Leehyunbin0131/Oh-My-MobileRobot/docs/references.md

# 자료 출처 / Design references

[한국어](../README.md) · [English](../README.en.md)

제조사 자료·제품 도면·프로젝트 실측과 설계 기준의 출처입니다. 실제 규격은 [구매 부품 사양](components.ko.md), 체결부 치수는 [출력 부품 설계 규격](design.ko.md), 조립 모델 좌표는 [전체 모델](full-model.ko.md)에 있습니다.

This page identifies manufacturer data, product drawings, project measurements, and design references. Values are documented in [purchased component specifications](components.en.md), [printed part design specifications](design.en.md), and the [complete model layout](full-model.en.md).

| 대상 / Item | 출처 / Source | 적용 항목 / Scope |
| --- | --- | --- |
| 프레임 / Frame | 프로젝트 실측·요구사항 / Project measurements and requirements | 프레임 외곽·프로파일 구성 / Frame envelope and extrusion layout |
| RPLIDAR A2M12 | [SLAMTEC A2M12 datasheet v1.0](https://wiki.slamtec.com/download/attachments/83066883/LD310_SLAMTEC_rplidar_datasheet_A2M12_v1.0_en.pdf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) | 센서 외형·장착 패턴·나사 삽입 한도 / Sensor envelope, mounting pattern, screw insertion limit |
| RealSense D435i | [D400 datasheet, August 2025](https://www.realsenseai.com/wp-content/uploads/2025/08/Intel-RealSense-D400-Series-Datasheet-August-2025.pdf) | Figure 10-9: 후면 체결·외형 / Rear mounting and exterior envelope |
| XT60 / XT60H | [AMASS product catalog](https://www.china-amass.com/public/upload/20240723/c1ae9604bbe795ebfd366c9063019e3e.pdf) | Catalog page 13: 표준 단자 단면 / Standard connector cross sections |
| Arduino Mega 2560 | [Arduino hardware documentation](https://docs.arduino.cc/hardware/mega-2560/) | 기판 외곽·고정홀 / Board outline and mounting pattern |
| NT-S-DCDM1210 | 프로젝트에 제공된 제조사 매뉴얼 `NT-S-DCDM1210.pdf`, p.7 / Manufacturer manual supplied for the project, p.7 | 기판 외곽·고정홀, 매뉴얼 재배포 제외 / Board envelope and mounting pattern; manual not redistributed |
| SZH-EKBD-058 | [Product listing](https://www.devicemart.co.kr/goods/view?no=1342925), 실물 실측 / hardware measurements | 본체 외형·실측 홀 간격·방열판 여유 / Body envelope, measured hole pitch, heatsink clearance |
| SZH-EK334 | [Product listing](https://www.devicemart.co.kr/goods/view?no=10826138), 실물 실측 / hardware measurements | 실측 고정홀 간격 / Measured mounting-hole pitch |
| KIT0085 | [DFRobot official product](https://www.dfrobot.com/product-1203.html) | 모터·바퀴 제품 규격 / Motor and wheel specifications |
| Motor bracket | 판매처 제품 도면 / Supplier product drawing | 절곡 외형·중심 개구부·조정홀 / Formed envelope, center opening, adjustment holes |
| 3-inch casters | 판매처 제품 도면 / Supplier product drawing | 바퀴·장착판·회전축 치수 / Wheel, mounting plate, and swivel dimensions |
| Jetson Orin Nano Super / HFI-A9 | 시스템 구성 사양 / System hardware specification | 메인 PC·IMU 모델 / Main computer and IMU models |
| 해머형 T너트 / Hammer T-nut | 프로젝트 설계 참고 외형 / Project design reference envelope | 측면 판 키홀의 기준 외형 / Reference envelope for side-panel keyholes |

출력 부품의 치수에는 제품 규격, 실물 실측값, 설계 여유가 구분되어 있습니다. / Printed part dimensions distinguish product specifications, hardware measurements, and design clearances.

## ROS 모델 자료 / ROS model references

ROS 모델의 사용법과 프로젝트 좌표 변환은 [한국어](ros.ko.md) / [English](ros.en.md)에 있습니다. / Usage and project coordinate conversion are documented in the linked ROS pages.

| 대상 / Item | 출처 / Source | 적용 항목 / Scope |
| --- | --- | --- |
| 단위·좌표축 / Units and axes | [REP-103](https://github.com/ros-infrastructure/rep/blob/master/rep-0103.rst) | SI 단위·로봇 축·광학 프레임 / SI units, robot axes, optical frames |
| 패키지 형식 / Package format | [REP-149](https://github.com/ros-infrastructure/rep/blob/master/rep-0149.rst) | format 3, ROS_VERSION 조건부 의존성과 빌드 방식 / Conditional dependencies and build types |
| TF 발행 / TF publication | [robot_state_publisher](https://github.com/ros/robot_state_publisher) | URDF·관절 상태와 링크 변환 / URDF, joint states, and link transforms |
| 표시용 관절 상태 / Display joint states | [joint_state_publisher](https://github.com/ros/joint_state_publisher) | GUI·기본 관절 상태 / GUI and default joint states |
| URDF 매개변수화 / URDF parameters | [xacro](https://github.com/ros/xacro) | 공통 모델·모델 선택·이름 접두사 / Common description, variants, and name prefix |
| 형상 출처 / Geometry sources | [CAD 매핑 / CAD mapping](../ros/oh_my_mobilerobot_description/config/cad_mapping.json) · [메시 명세 / Mesh manifest](../ros/oh_my_mobilerobot_description/config/mesh_manifest.json) | 저장소 CAD에서 추출한 바디·원본 SHA-256 / Bodies derived from repository CAD and source SHA-256 |
