Leehyunbin0131/Oh-My-MobileRobot/hardware/camera-mount/drawings/d435i-bracket-v2-1to1.pdf

# 브라켓 1:1 제작 도면

D435i / 2020 프로파일 / V2 / 단위 mm / 모든 형상 도면 축척 1:1

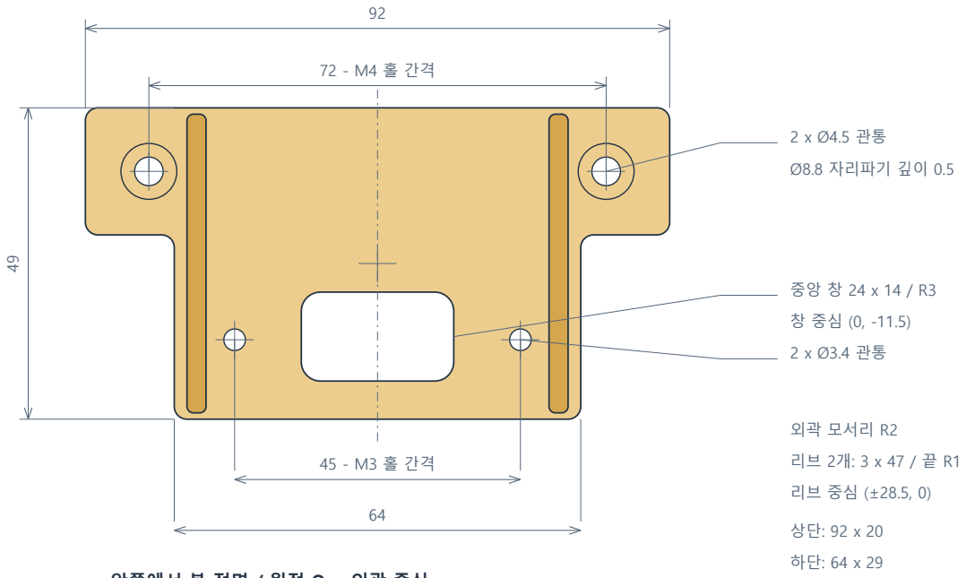
[picture p28: figure]
Ø8.8 자리파기 깊이 0.5; 외곽 모서리 R2

인쇄: 실제 크기 100% · 페이지 맞춤 해제 · 아래 50 mm 기준선으로 확인 | 1 / 2

50 mm

### 안쪽에서 본 정면 / 원점 O = 외곽 중심

64

6.5

본체 3.5

### 가로 단면 / 보강대 포함

M3 x 6 → 삽입 2.5

M4 x 8 → 홈 쪽 돌출 5

M4 받침 두께 3.0

## 홀 중심 좌표 (원점 O 기준)

용도 | X | Y | 구멍
카메라 좌 / 우 | -22.5 / +22.5 | -12.0 | Ø3.4
프로파일 좌 / 우 | -36.0 / +36.0 | +14.5 | Ø4.5 + Ø8.8 x 0.5

### 제작 순서: 외곽·구멍 스케치 → 한 바디 6.5 돌출 → 뒷면 절삭 → M4 자리파기

최종 형상: 한 개의 닫힌 솔리드. 위·아래 본체는 동일한 3.5 두께이며 가로 단차가 없음.

# 장착 위치 및 일자형 USB-C 여유 공간

D435i / 2020 프로파일 / V2 / 단위 mm / 모든 형상 도면 축척 1:1

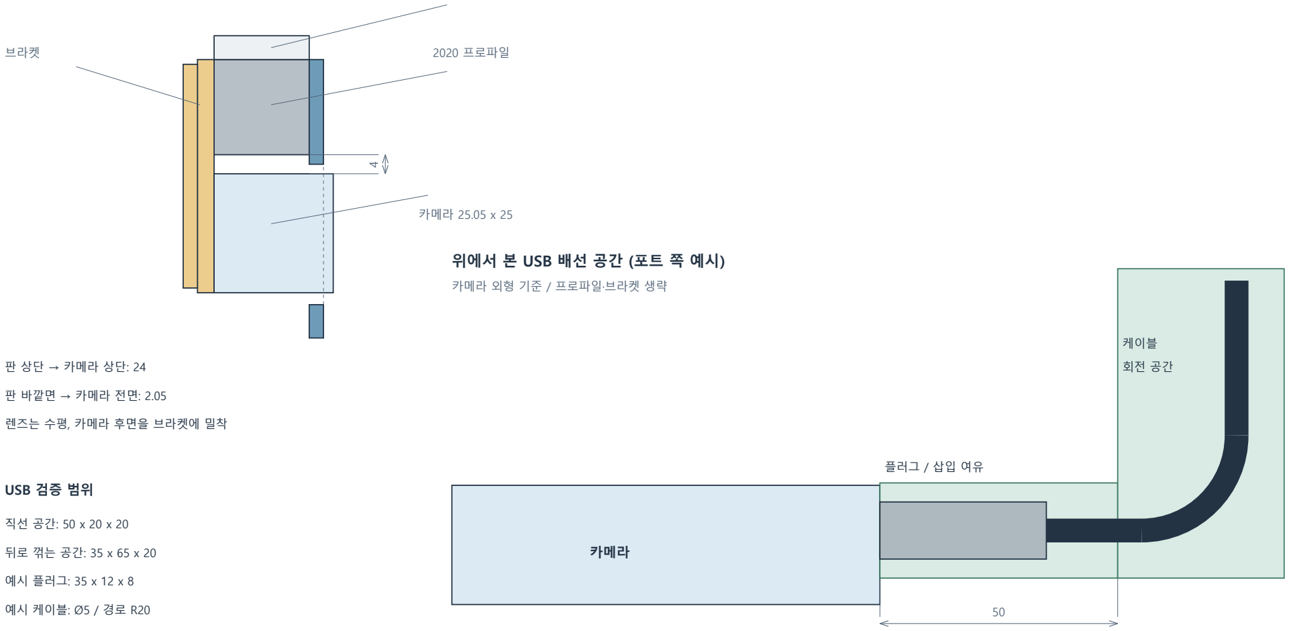
[picture p29: figure]
카메라 25.05 x 25; 2020 프로파일; 판 바깥면 → 카메라 전면: 2.05; 렌즈는 수평, 카메라 후면을 브라켓에 밀착; 위에서 본 USB 배선 공간 (포트 쪽 예시); 카메라 외형 기준 / 프로파일·브라켓 생략; 카메라; 플러그 / 삽입 여유; 케이블; USB 검증 범위; 예시 플러그: 35 x 12 x 8; 예시 케이블: Ø5 / 경로 R20

인쇄: 실제 크기 100% · 페이지 맞춤 해제 · 아래 50 mm 기준선으로 확인 | 2 / 2

50 mm

## 측면 배치 (로봇 안쪽 ← / → 바깥)

브라켓

기존 상판 5T

판 상단 → 카메라 상단: 24

실제 케이블 몸통 치수·최소 굽힘 반경은 미확인.

녹색은 물체가 없는 공간. 예시 플러그와 경로는 실측 제품 형상이 아님.
