Leehyunbin0131/Oh-My-MobileRobot/hardware/side-panels/drawings/side-panel-180-1to1.pdf

# 180 mm 추가 측면 판

### 폭 180 × 높이 140 / 표면 1 + 안쪽 리브 2 = 최대 3 mm / 축척 1:1

출력 수량: 1개

기존 측면 판과 같은 구조

환기 구멍 없음

표면 1 / 보강 포함 최대 3

가장자리 폭 6

세로 리브 3개 / 가로 1개

리브 폭 2.4 / 포켓 R2

바깥 모서리 0.5 × 45°

M4 × 8 + T너트 4세트

고정 중심 X = 40, 145

고정 중심 Y = 10, 130

T너트 삽입구 14 × 8 R1

볼트 이동 통로 폭 4.5

판을 가로로 15 mm 이동

확대 삽입구는 고정점 오른쪽

평평한 외측면을 베드에

단위 mm / 100% 크기 인쇄

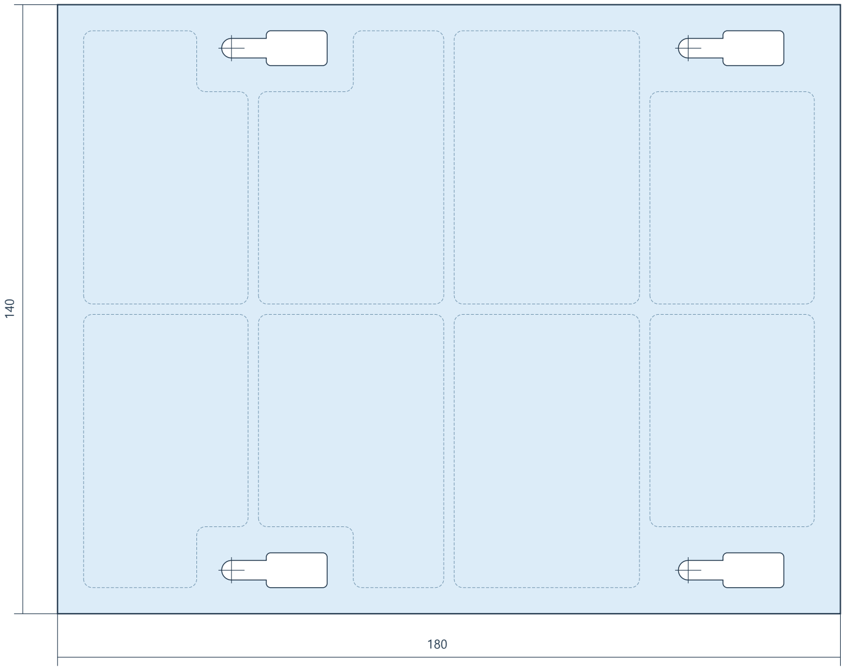
[picture p30: figure]

실선: 외곽·관통 체결구 / 점선: 안쪽 경량 포켓. 도면과 같은 치수로 SolidCraft 모델링.
