Leehyunbin0131/Oh-My-MobileRobot/docs/components.ko.md

# 구매 부품 사양

[한국어 README](../README.md) · [English](components.en.md) · [자료 출처](references.md) · [ROS 모델](ros.ko.md)

구매 부품의 모델·수량·제품 규격을 설명합니다. 치수는 mm입니다. 프레임 내 장착 위치는 [전체 모델 배치](full-model.ko.md#layout), 기판 고정홀과 전장판 배치는 [출력 부품 설계 규격](design.ko.md#electronics-trays)에 있습니다.

## 구동부 — DFRobot KIT0085

DFRobot Rubber Wheel & Motor Kit의 모터와 바퀴를 각각 2개 사용합니다.

| 항목 | 제품 규격 |
| --- | --- |
| 모터 | 28PA51G, 12 V |
| 모터 외형 | 123 × 36 × 36 |
| 바퀴 | Ø136 × 폭 24 |

## 모터 브라켓 — 범용 금속 브라켓 2개

750/755/775/795/895 DC 모터와 28/35/42 스테퍼 모터용으로 판매되는 범용 브라켓입니다.

| 항목 | 제공된 제품 도면 기준 |
| --- | --- |
| 폭 | 50 ±0.1 |
| 절곡 후 세로 다리 | 51~51.5 |
| 절곡 후 바닥 다리 | 53~53.5 |
| 전개 길이 | 100 ±0.1 |
| 모터 중심 개구부 | Ø22.1 |
| 모터 측 조정홀 | 도면 표기 4×Ø3.5, 조정 범위 20~31 |
| 바닥 슬롯 | 폭 4.2, 끝단 R2.1, 도면상 길이 치수 30 |
| 바닥 슬롯 열 간격 | 30 ±0.1 |

## 캐스터 — 3인치, 2개

| 항목 | 제공된 제품 도면 기준 |
| --- | --- |
| 바퀴 지름 | Ø76 |
| 전체 설치 높이 | 101 |
| 폭 표시값 | 33 |
| 장착판 외곽 | 95 × 64 |
| 장착 슬롯 열 간 세로 피치 | 44.5 |
| 가로 피치 표시 | 기준 72.3 / 조정 범위 68.3~76.3 |
| 슬롯 폭 | 8.5, 끝단 R4.3 표기 |
| 추가 원형 홀 | Ø9 표기 |
| 회전 중심과 바퀴 축 오프셋 | 도면 표시 34 |
| 장착판 윗면부터 바퀴 축까지 | 도면 표시 63 |

## 연산·제어·센서

| 부품 | 수량 | 역할·제품 정보 |
| --- | --- | --- |
| NVIDIA Jetson Orin Nano Super | 1 | 메인 PC |
| Arduino Mega 2560 | 1 | 마이크로컨트롤러 |
| NT-S-DCDM1210 | 1 | 모터 드라이버 |
| RPLIDAR A2M12 | 1 | 라이다, 외형 Ø76 × 높이 41 |
| RealSense D435i | 1 | 깊이 카메라 |
| HFI-A9 | 1 | IMU |

## DC-DC 컨버터

| 부품 | 수량 | 제품 정보 |
| --- | --- | --- |
| SZH-EKBD-058 | 2 | 감압 모듈, 본체 60 × 51 × 22 |
| LTC3780 SZH-EK334 | 1 | 승·감압 모듈 |

## 프레임 부재 — 2020 알루미늄 프로파일

기본 베이스(`440 × 400 × 140`)와 공통 3층 확장 플랫폼의 CAD 기준 부재 구성입니다. 배치 좌표는 [전체 모델 구성과 배치](full-model.ko.md)에 있습니다.

| 구분 | 규격 | 수량 | 배치·역할 |
| --- | --- | --- | --- |
| 기본 베이스 가로 부재 | 2020 프로파일, 길이 400 | 6 | 상·하부 전·후면 4개, 상부 중앙 라이다 고정 1개, 하부 후방 캐스터 지지 1개 |
| 기본 베이스 세로 부재 | 2020 프로파일, 길이 360 | 4 | 상·하부 좌·우 측면 4개 |
| 기본 베이스 수직 기둥 | 2020 프로파일, 길이 140 | 4 | 네 바깥 모서리 수직 연결 |
| 3층 확장 기둥 | 2020 프로파일, 길이 200 | 4 | 확장 예시 공통 모서리 기둥 (하부 L 브라켓 4개, 상부 삼각 연결판 4개 결합) |
| 3층 상부 프레임·판재 | 2020 길이 400 (3개) · 360 (2개), 440 × 400 × 3 알루미늄 판재 (1장) | 1세트 | 확장 모듈 지지 플랫폼 (로봇암형은 가로 보강 부재 2개 추가) |

## 체결 부품·서포터

출력 외장·센서 브라켓·전장판 기준 체결 부품 수량입니다. 체결부 상세 치수는 [출력 부품 설계 규격](design.ko.md)에 있습니다.

| 부품 | 규격 | 수량 | 사용 위치 |
| --- | --- | --- | --- |
| 프로파일 체결 볼트·T너트 | M4 × 8 볼트 + M4 해머형 T너트 (10 × 6 × 3.5) | 50세트 | 상판 16세트, 전면·측면·후면 분할 커버 8장 32세트(판당 4곳), D435i 브라켓 2세트 |
| 센서 고정 볼트 | M3 × 6 볼트 | 6 | RPLIDAR A2M12 고정 4개(일반 머리), RealSense D435i 고정 2개 |
| 기판용 금속 서포터 | M3 PCB 서포터, 몸통 10 (수나사 5 기준) | 26 | 전장판 아래판 14곳, 위판 12곳 파일럿 홀 체결 |
| 층간 금속 서포터 | M3 PCB 서포터, 몸통 40 | 4 | 2층 전장판 모서리 층간 연결 (150 × 150 간격) |
