Leehyunbin0131/Oh-My-MobileRobot/docs/parts.en.md

# Design file index

[English README](../README.en.md) · [한국어](parts.ko.md) · [Dimensions and fasteners](design.en.md) · [Print orientations](printing.en.md)

This index covers CAD, printing, and ROS downloads and source file contents. See [printed part design specifications](design.en.md) for dimensions and mounting interfaces, [printing instructions](printing.en.md) for output settings, and [ROS model usage](ros.en.md) for running the models.

## Printed part files

| Part | Included files | Downloads |
| --- | --- | --- |
| [Top deck](design.en.md#top-deck) | Front left/right and rear left/right panels | [STL](../hardware/top-deck/print) · [CAD](../hardware/top-deck/cad) · [1:1 drawing](../hardware/top-deck/drawings/top-deck-1to1.pdf) |
| [Side covers](design.en.md#side-panels) | 200 / 220 / 180 mm panels | [STL](../hardware/side-panels/print) · [CAD](../hardware/side-panels/cad) · [180 mm panel 1:1 drawing](../hardware/side-panels/drawings/side-panel-180-1to1.pdf) |
| [D435i mount](design.en.md#camera-mount) | Left/right front covers and V2 bracket | [STL](../hardware/camera-mount/print) · [CAD](../hardware/camera-mount/cad) · [1:1 drawing](../hardware/camera-mount/drawings/d435i-bracket-v2-1to1.pdf) |
| [Electronics trays](design.en.md#electronics-trays) | Lower and upper trays | [STL](../hardware/electronics-tray/print) · [CAD](../hardware/electronics-tray/cad) |

M3 fit coupon: [download STL](../hardware/electronics-tray/print/m3-pilot-fit-coupon.stl) · [usage](printing.en.md#fit-check)

### Camera source file contents

- [camera-panels.sc](../hardware/camera-mount/cad/camera-panels.sc): contains the left/right cover history and a hidden earlier bracket; only the two covers are displayed.
- [d435i-bracket-v2.sc](../hardware/camera-mount/cad/d435i-bracket-v2.sc): the current V2 bracket source. Its printable counterpart is [d435i-bracket-v2.stl](../hardware/camera-mount/print/d435i-bracket-v2.stl).

## Complete model and application concepts

See [complete model and application concepts](full-model.en.md) for each model's exterior and layout dimensions.

| Model | CAD source and STEP |
| --- | --- |
| Base platform | <sub>[SolidCraft](../hardware/assembly/full-robot-reference.sc) · [STEP](../hardware/assembly/full-robot-reference.step)</sub> |
| Cargo carrier concept | <sub>[SolidCraft](../hardware/application-examples/cargo-concept.sc) · [STEP](../hardware/application-examples/cargo-concept.step)</sub> |
| Six-axis robot arm concept | <sub>[SolidCraft](../hardware/application-examples/arm-concept.sc) · [STEP](../hardware/application-examples/arm-concept.step)</sub> |
| Information display concept | <sub>[SolidCraft](../hardware/application-examples/display-concept.sc) · [STEP](../hardware/application-examples/display-concept.step)</sub> |

## ROS model files

Download the complete [oh_my_mobilerobot_description package](../ros/oh_my_mobilerobot_description). Its URDFs reference meshes inside the package.

| File | Contents |
| --- | --- |
| [Base platform](../ros/oh_my_mobilerobot_description/urdf/base.urdf) | `base` URDF |
| [Cargo carrier](../ros/oh_my_mobilerobot_description/urdf/cargo.urdf) | `cargo` URDF |
| [Robot arm](../ros/oh_my_mobilerobot_description/urdf/arm.urdf) | `arm` URDF |
| [Information display](../ros/oh_my_mobilerobot_description/urdf/display.urdf) | `display` URDF |
| [Common Xacro](../ros/oh_my_mobilerobot_description/urdf/oh_my_mobilerobot.urdf.xacro) | Model selection and link/joint name prefix |
| [Visual meshes](../ros/oh_my_mobilerobot_description/meshes/visual) | Metre-scale STLs in link coordinates |
| [Launch files](../ros/oh_my_mobilerobot_description/launch) · [RViz configurations](../ros/oh_my_mobilerobot_description/rviz) | ROS 1 and ROS 2 display settings |
| [CAD mapping](../ros/oh_my_mobilerobot_description/config/cad_mapping.json) · [Mesh manifest](../ros/oh_my_mobilerobot_description/config/mesh_manifest.json) | Source mapping, coordinates, colors, SHA-256 hashes, and bounds |
| [Conversion tool](../tools/generate_ros_description.py) · [Checks](../tests/test_ros_description.py) | CAD-based regeneration and model checks |

See [ROS model usage](ros.en.md) for building, launching, frames, and customization.

## File formats and selection

| Format | Contents |
| --- | --- |
| `.sc` | Editable SolidCraft source |
| `.step` | Solid geometry for exchange between CAD programs |
| `.stl` | `hardware/**/print/`: print meshes (mm); `ros/**/meshes/visual/`: visual meshes (m) |
| `.pdf` | Part and layout drawings |
| `.urdf` | ROS link, joint, visual, and collision definitions |
| `.xacro` | Common URDF source with model selection and a name prefix |

Use the STLs in each part's `print/` folder for printing. Hidden reference boards and extrusions in CAD sources are not printable parts. Complete exterior and application models are available as SolidCraft and STEP for CAD editing and exchange and URDF and Xacro for ROS. Print units and scale are covered in [printing instructions](printing.en.md); ROS units and coordinates are in the [ROS document](ros.en.md#frames).
