Leehyunbin0131/Oh-My-MobileRobot/hardware/assembly/full-robot-reference.step

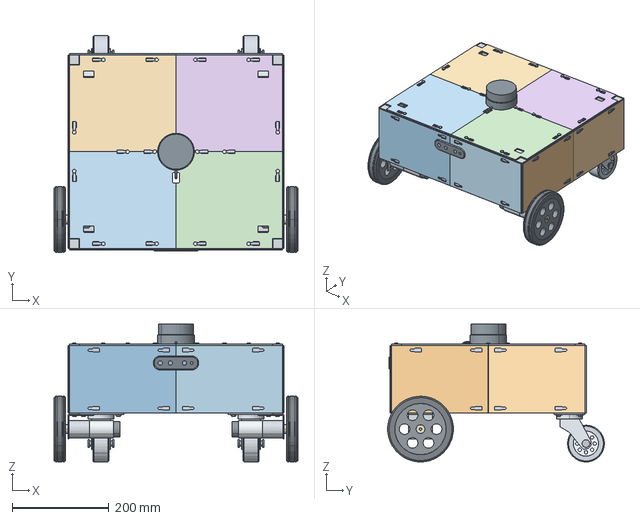
[picture p31: CAD file, 2026-11-04]
hardware/assembly/full-robot-reference.step
504.0 x 447.4 x 285.0 mm
