Leehyunbin0131/Oh-My-MobileRobot/hardware/application-examples/display-concept.step

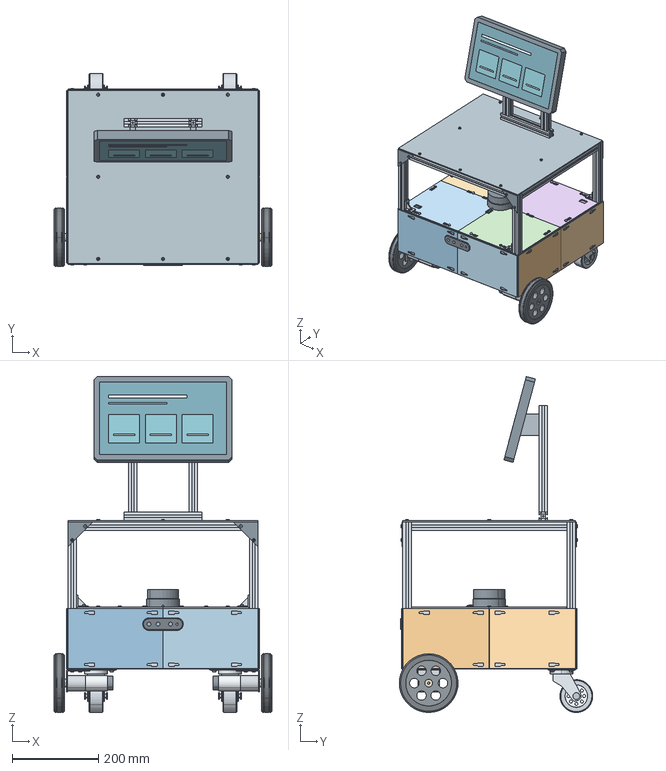
[picture p32: CAD file, 2026-11-04]
hardware/application-examples/display-concept.step
504.0 x 447.6 x 777.6 mm
