Leehyunbin0131/Oh-My-MobileRobot/hardware/camera-mount/cad/camera-panel-right.step

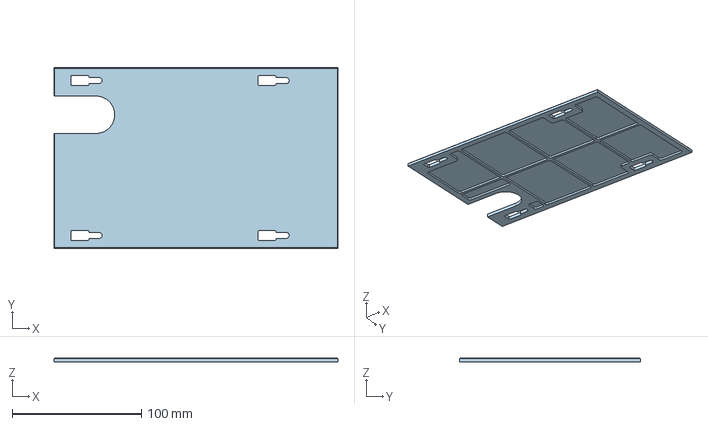
[picture p33: CAD file, 2026-11-04]
hardware/camera-mount/cad/camera-panel-right.step
220.0 x 140.0 x 3.00 mm
