Leehyunbin0131/Oh-My-MobileRobot/hardware/electronics-tray/cad/electronics-tray.step

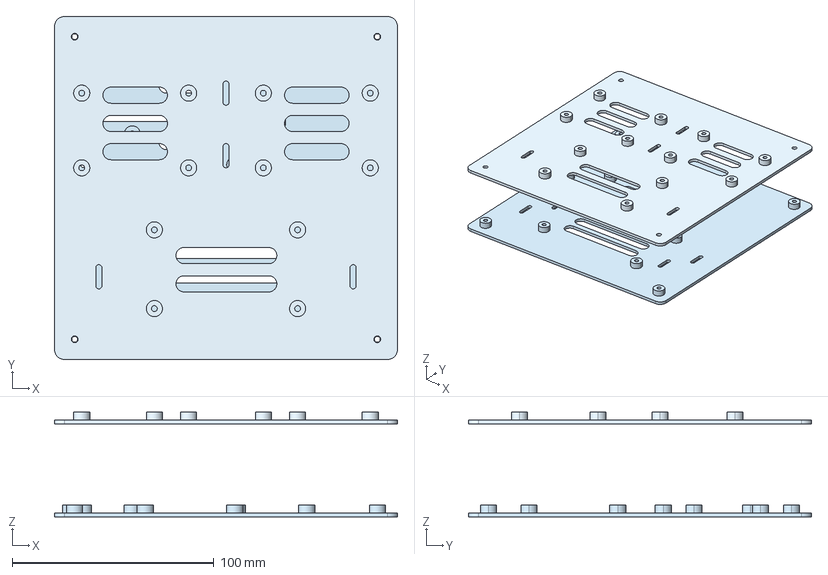
[picture p34: CAD file, 2026-11-04]
hardware/electronics-tray/cad/electronics-tray.step
170.0 x 170.0 x 52.0 mm
