Leehyunbin0131/Oh-My-MobileRobot/hardware/electronics-tray/print/lower-plate-mega180.stl

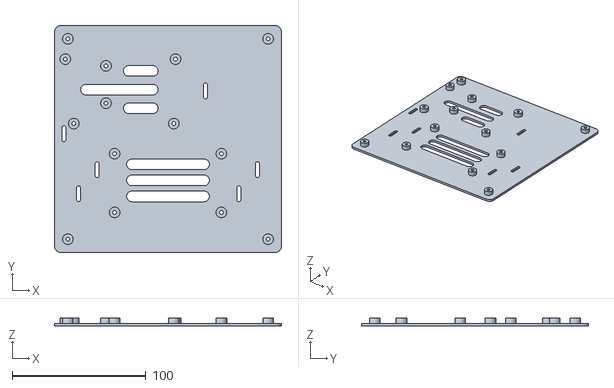
[picture p35: CAD file, 2026-11-04]
hardware/electronics-tray/print/lower-plate-mega180.stl
170.0 x 170.0 x 6.00
