Leehyunbin0131/Oh-My-MobileRobot/hardware/side-panels/cad/side-panel-180.step

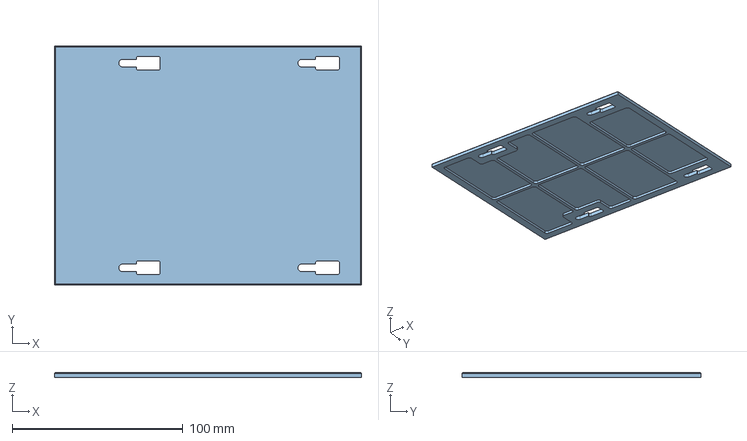
[picture p36: CAD file, 2026-11-04]
hardware/side-panels/cad/side-panel-180.step
180.0 x 140.0 x 3.00 mm
