Leehyunbin0131/Oh-My-MobileRobot/hardware/top-deck/cad/top-deck.step

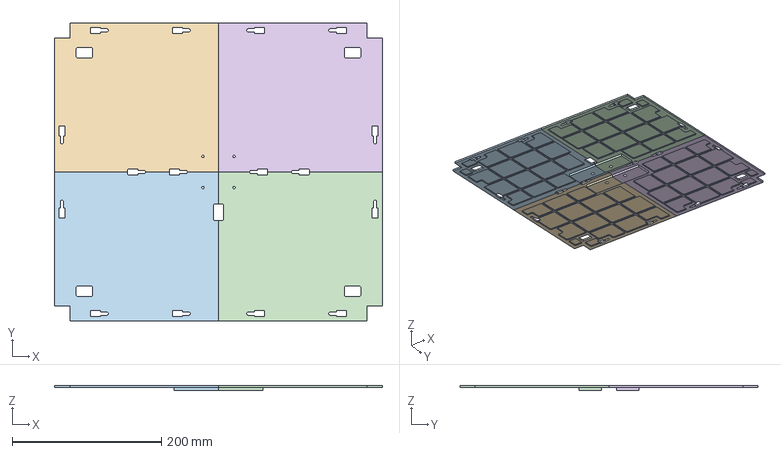
[picture p37: CAD file, 2026-11-04]
hardware/top-deck/cad/top-deck.step
440.0 x 400.0 x 7.00 mm
