Leehyunbin0131/Oh-My-MobileRobot/hardware/top-deck/print/03_Rear_Left.stl

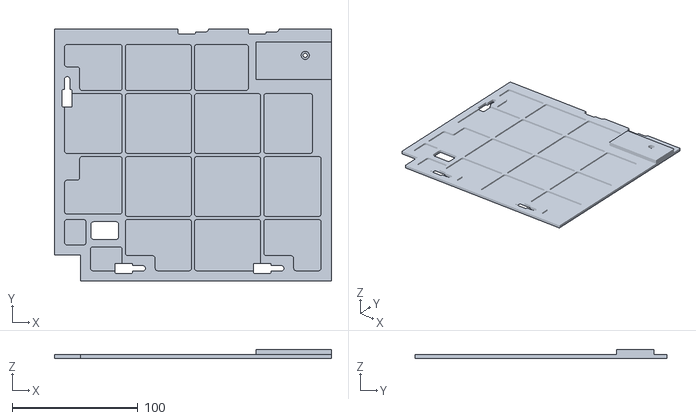
[picture p38: CAD file, 2026-11-04]
hardware/top-deck/print/03_Rear_Left.stl
220.0 x 200.0 x 7.00
