Leehyunbin0131/Oh-My-MobileRobot/ros/oh_my_mobilerobot_description/meshes/visual/arm_module/arm.stl

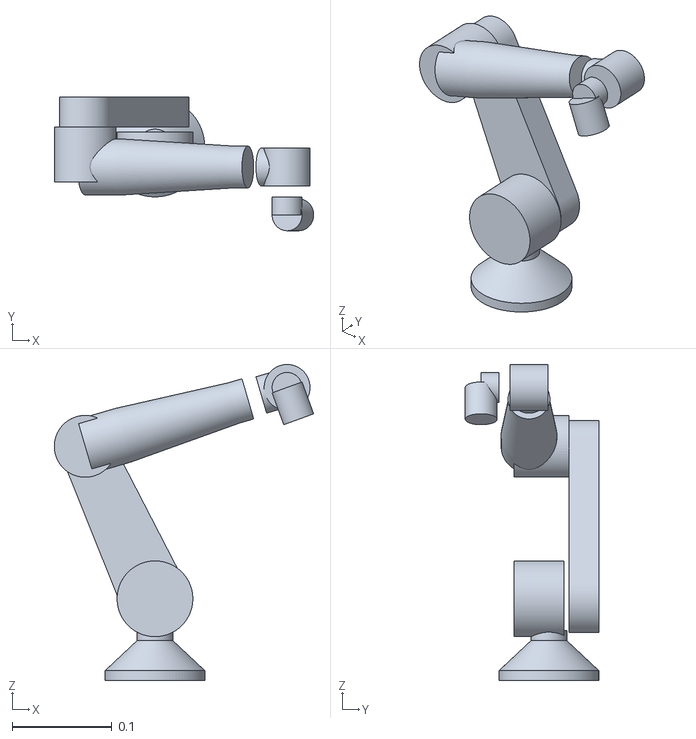
[picture p39: CAD file, 2026-11-04]
ros/oh_my_mobilerobot_description/meshes/visual/arm_module/arm.stl
0.26 x 0.134 x 0.317
