Leehyunbin0131/Oh-My-MobileRobot/ros/oh_my_mobilerobot_description/meshes/visual/base_link/deck.stl

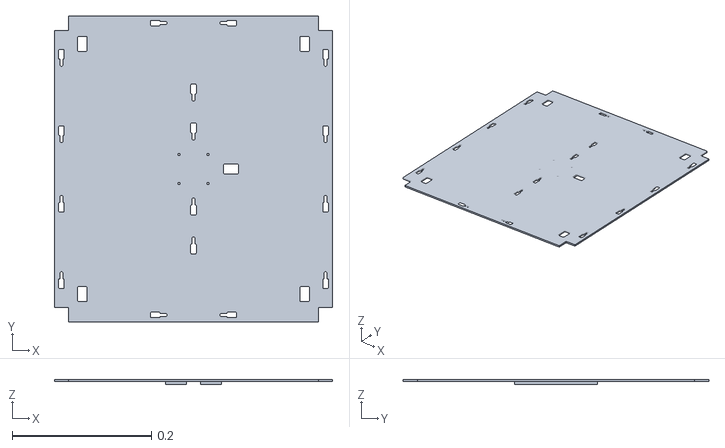
[picture p40: CAD file, 2026-11-04]
ros/oh_my_mobilerobot_description/meshes/visual/base_link/deck.stl
0.4 x 0.44 x 0.007
