Leehyunbin0131/Oh-My-MobileRobot/ros/oh_my_mobilerobot_description/meshes/visual/camera_link/sensor.stl

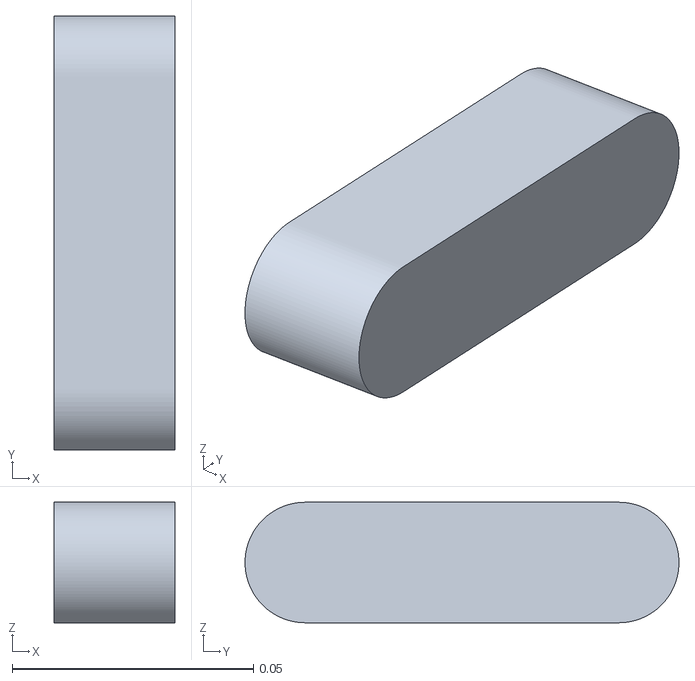
[picture p41: CAD file, 2026-11-04]
ros/oh_my_mobilerobot_description/meshes/visual/camera_link/sensor.stl
0.025 x 0.09 x 0.025
