Leehyunbin0131/Oh-My-MobileRobot/ros/oh_my_mobilerobot_description/meshes/visual/left_caster_swivel_link/metal.stl

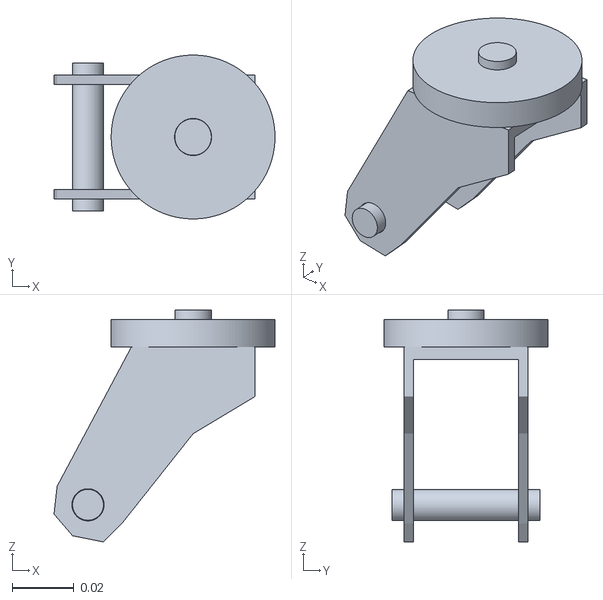
[picture p44: CAD file, 2026-11-04]
ros/oh_my_mobilerobot_description/meshes/visual/left_caster_swivel_link/metal.stl
0.0715 x 0.053 x 0.075
