Leehyunbin0131/Oh-My-MobileRobot/ros/oh_my_mobilerobot_description/meshes/visual/left_caster_wheel_link/hub.stl

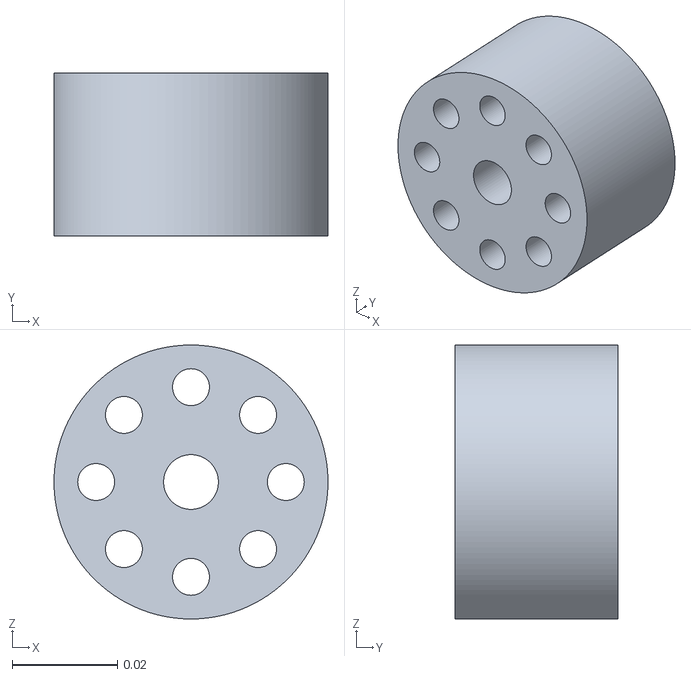
[picture p45: CAD file, 2026-11-04]
ros/oh_my_mobilerobot_description/meshes/visual/left_caster_wheel_link/hub.stl
0.052 x 0.031 x 0.052
