Leehyunbin0131/Oh-My-MobileRobot/ros/oh_my_mobilerobot_description/meshes/visual/left_wheel_link/metal.stl

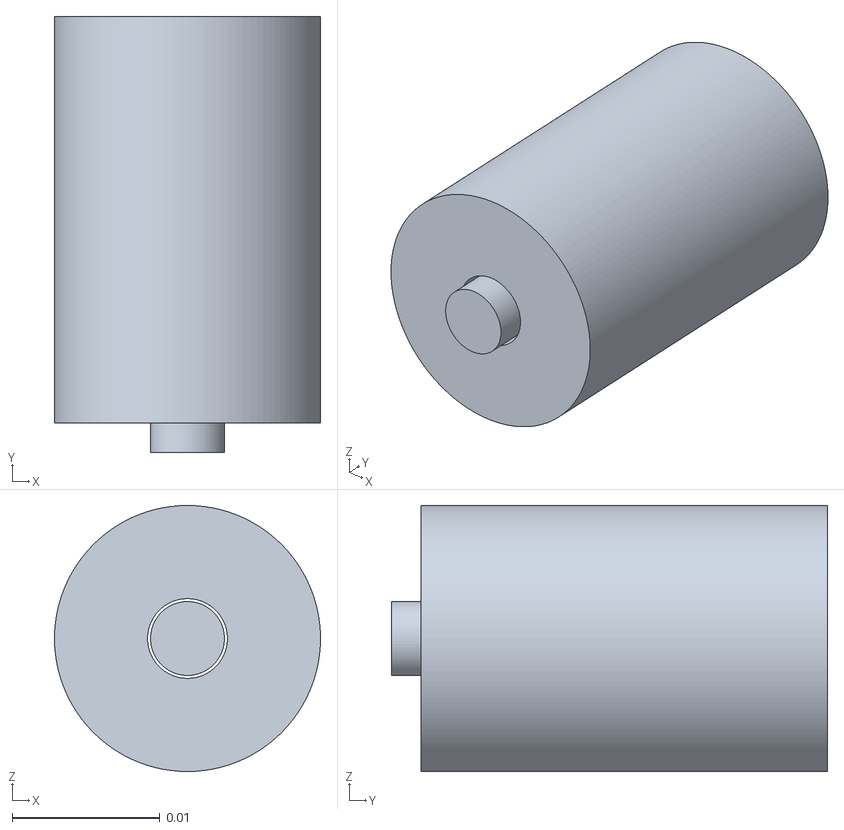
[picture p46: CAD file, 2026-11-04]
ros/oh_my_mobilerobot_description/meshes/visual/left_wheel_link/metal.stl
0.018 x 0.0295 x 0.018
