Leehyunbin0131/Oh-My-MobileRobot/ros/oh_my_mobilerobot_description/meshes/visual/lidar_link/sensor.stl

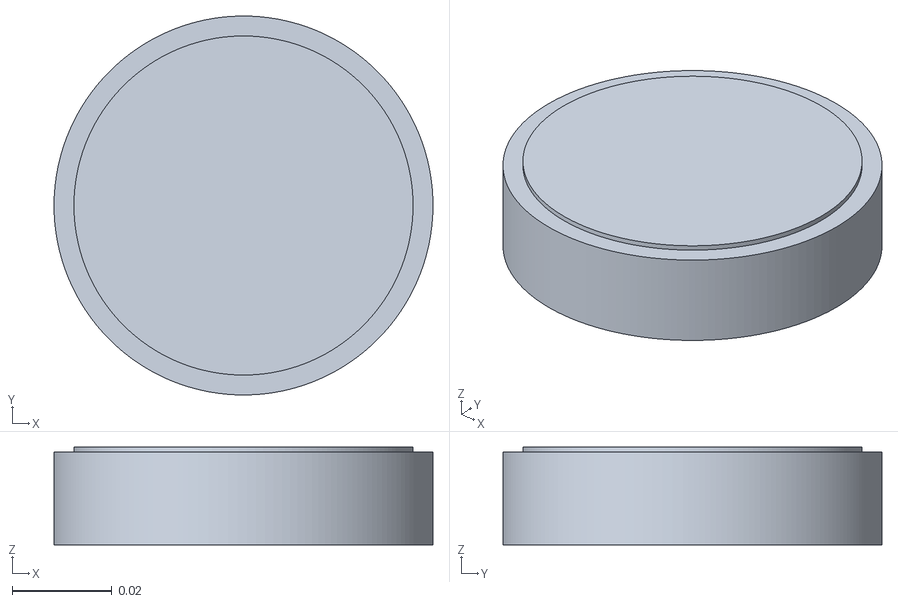
[picture p47: CAD file, 2026-11-04]
ros/oh_my_mobilerobot_description/meshes/visual/lidar_link/sensor.stl
0.076 x 0.076 x 0.0196
