Leehyunbin0131/Oh-My-MobileRobot/ros/oh_my_mobilerobot_description/meshes/visual/right_wheel_link/rubber.stl

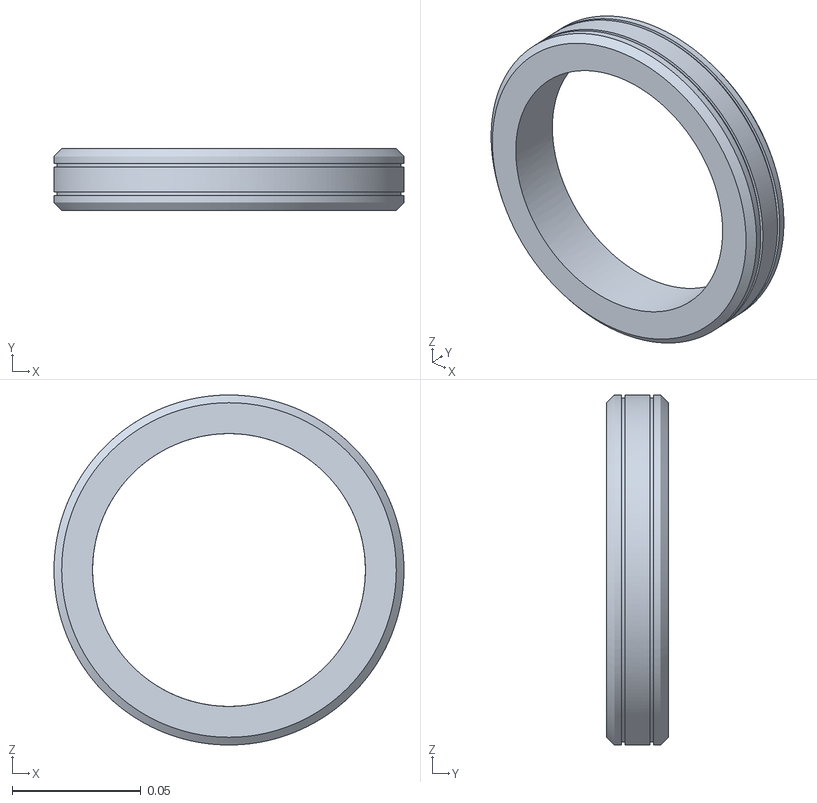
[picture p48: CAD file, 2026-11-04]
ros/oh_my_mobilerobot_description/meshes/visual/right_wheel_link/rubber.stl
0.136 x 0.024 x 0.136
