Leehyunbin0131/Oh-My-MobileRobot/hardware/application-examples/arm-concept.step

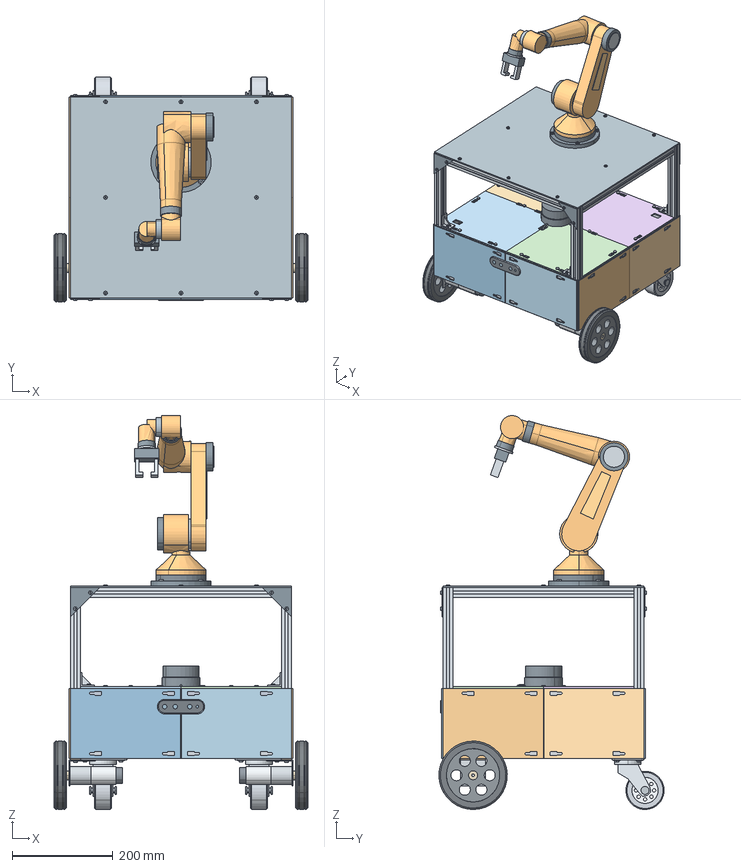
[picture p49: CAD file, 2026-11-04]
hardware/application-examples/arm-concept.step
504.0 x 447.6 x 783.1 mm
