Leehyunbin0131/Oh-My-MobileRobot/hardware/camera-mount/cad/d435i-bracket-v2.step

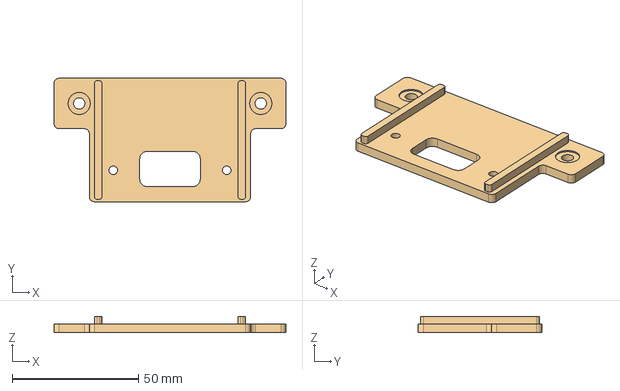
[picture p50: CAD file, 2026-11-04]
hardware/camera-mount/cad/d435i-bracket-v2.step
92.0 x 49.0 x 6.50 mm
