Leehyunbin0131/Oh-My-MobileRobot/hardware/side-panels/cad/side-panel-220.step

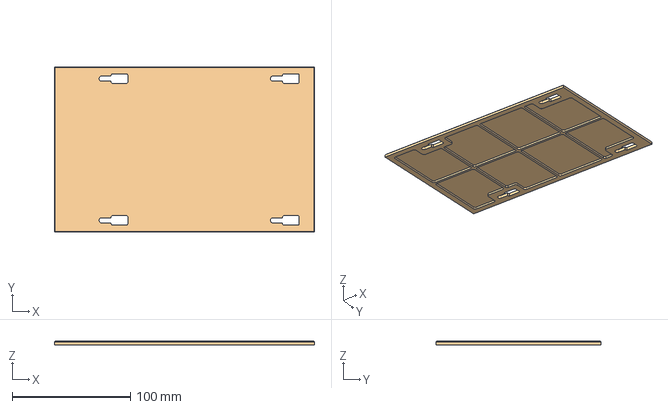
[picture p51: CAD file, 2026-11-04]
hardware/side-panels/cad/side-panel-220.step
220.0 x 140.0 x 3.00 mm
