Leehyunbin0131/Oh-My-MobileRobot/ros/oh_my_mobilerobot_description/meshes/visual/arm_module/joint.stl

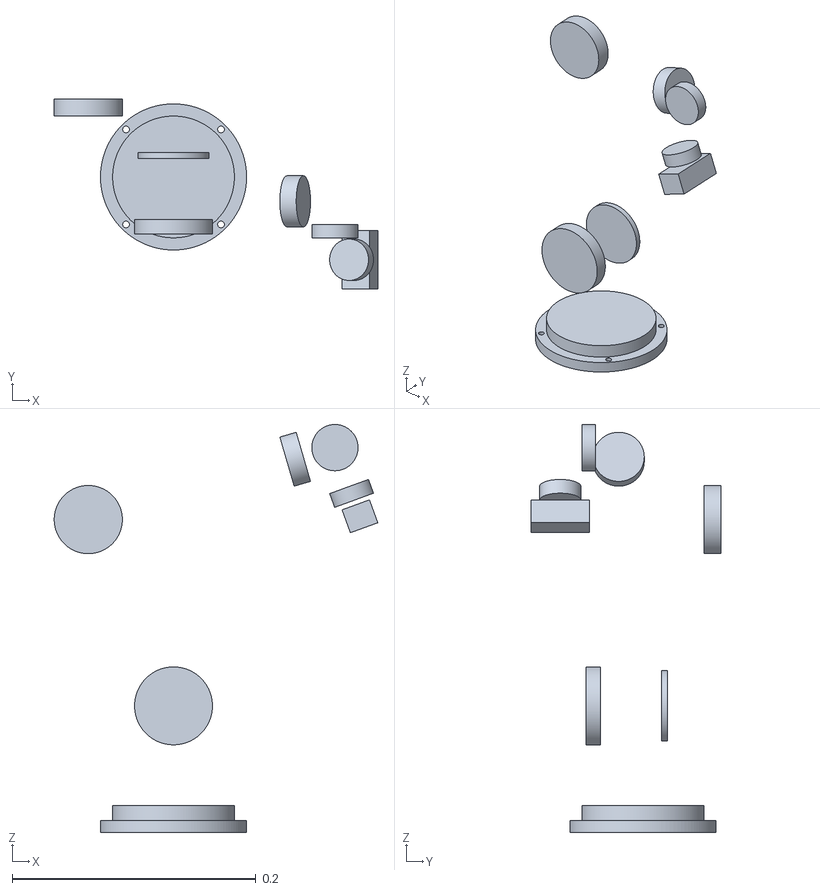
[picture p52: CAD file, 2026-11-04]
ros/oh_my_mobilerobot_description/meshes/visual/arm_module/joint.stl
0.266 x 0.156 x 0.335
