Leehyunbin0131/Oh-My-MobileRobot/ros/oh_my_mobilerobot_description/meshes/visual/base_link/joint.stl

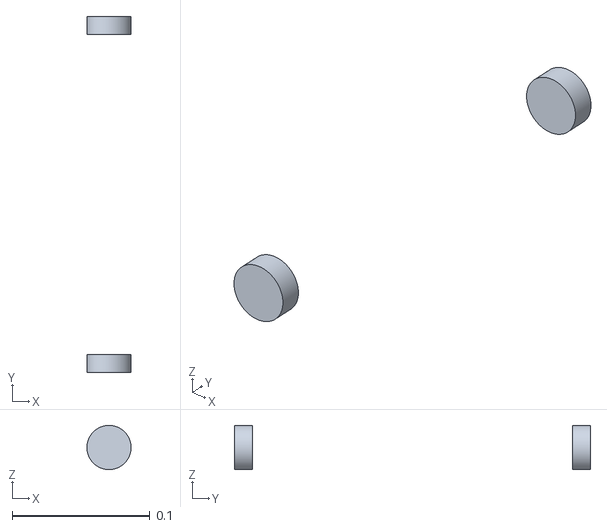
[picture p53: CAD file, 2026-11-04]
ros/oh_my_mobilerobot_description/meshes/visual/base_link/joint.stl
0.032 x 0.258 x 0.032
