Leehyunbin0131/Oh-My-MobileRobot/ros/oh_my_mobilerobot_description/meshes/visual/camera_link/rubber.stl

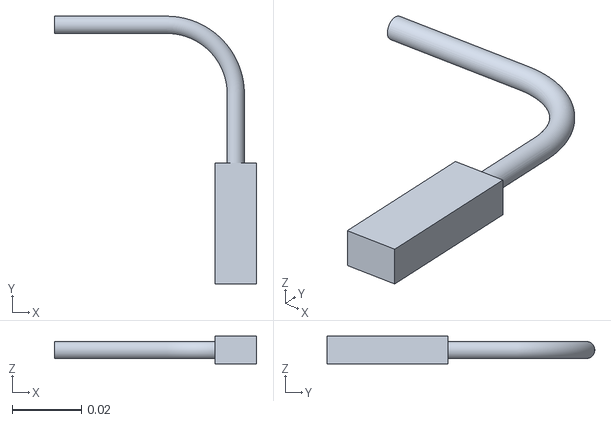
[picture p54: CAD file, 2026-11-04]
ros/oh_my_mobilerobot_description/meshes/visual/camera_link/rubber.stl
0.0585 x 0.0775 x 0.008
