Leehyunbin0131/Oh-My-MobileRobot/ros/oh_my_mobilerobot_description/meshes/visual/cargo_module/hub.stl

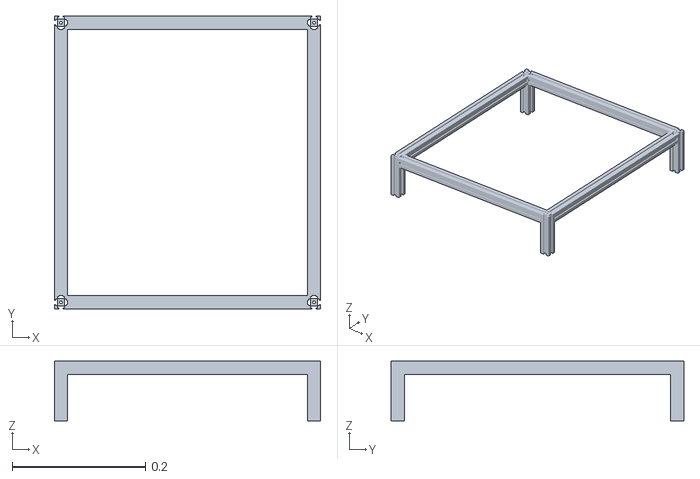
[picture p55: CAD file, 2026-11-04]
ros/oh_my_mobilerobot_description/meshes/visual/cargo_module/hub.stl
0.4 x 0.44 x 0.09
