Leehyunbin0131/Oh-My-MobileRobot/ros/oh_my_mobilerobot_description/meshes/visual/display_module/bracket.stl

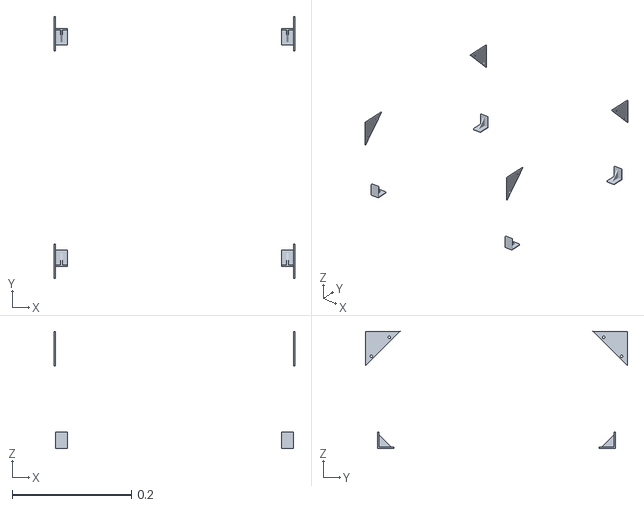
[picture p56: CAD file, 2026-11-04]
ros/oh_my_mobilerobot_description/meshes/visual/display_module/bracket.stl
0.404 x 0.44 x 0.197
