Leehyunbin0131/Oh-My-MobileRobot/ros/oh_my_mobilerobot_description/meshes/visual/left_caster_swivel_link/fastener.stl

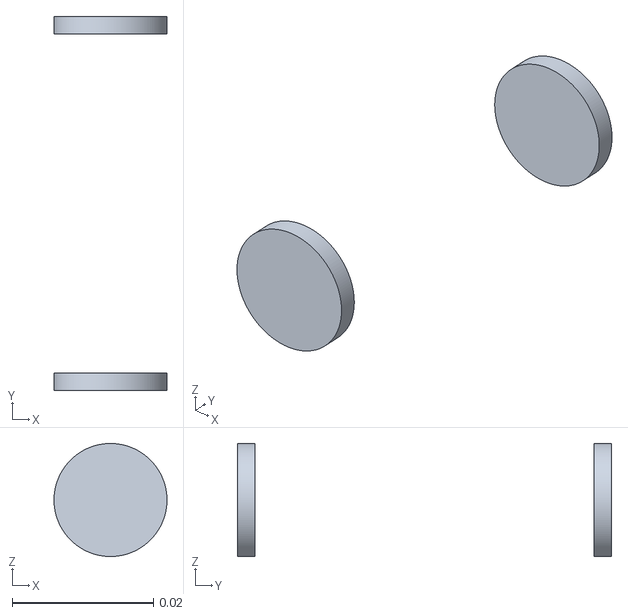
[picture p57: CAD file, 2026-11-04]
ros/oh_my_mobilerobot_description/meshes/visual/left_caster_swivel_link/fastener.stl
0.016 x 0.053 x 0.016
