Leehyunbin0131/Oh-My-MobileRobot/ros/oh_my_mobilerobot_description/meshes/visual/left_caster_wheel_link/rubber.stl

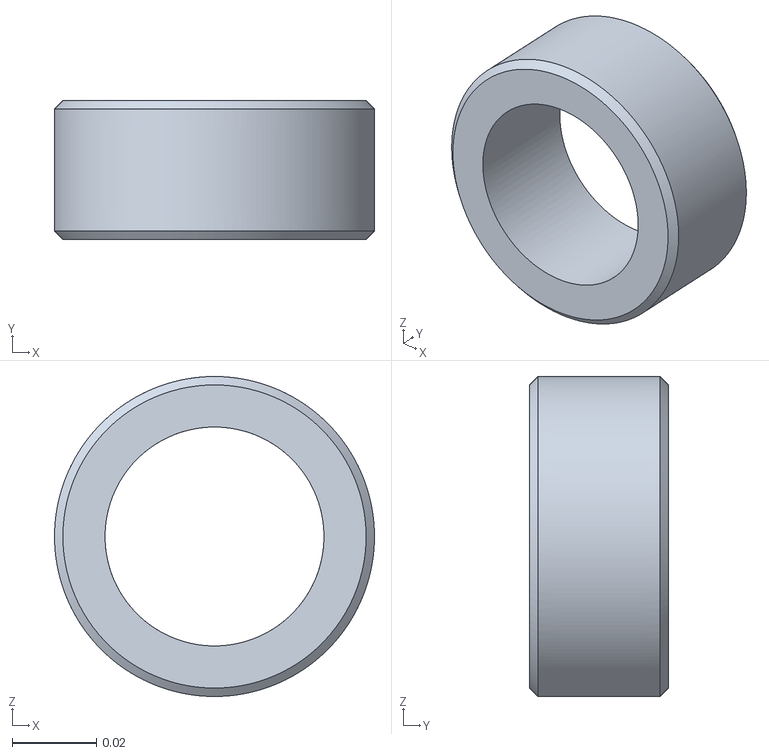
[picture p58: CAD file, 2026-11-04]
ros/oh_my_mobilerobot_description/meshes/visual/left_caster_wheel_link/rubber.stl
0.076 x 0.033 x 0.076
