Leehyunbin0131/Oh-My-MobileRobot/ros/oh_my_mobilerobot_description/meshes/visual/lidar_link/rubber.stl

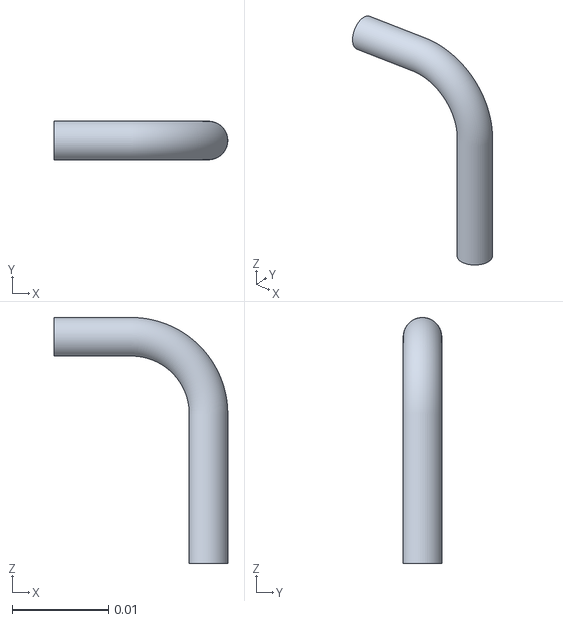
[picture p59: CAD file, 2026-11-04]
ros/oh_my_mobilerobot_description/meshes/visual/lidar_link/rubber.stl
0.018 x 0.004 x 0.0255
