Leehyunbin0131/Oh-My-MobileRobot/ros/oh_my_mobilerobot_description/meshes/visual/right_wheel_link/hub.stl

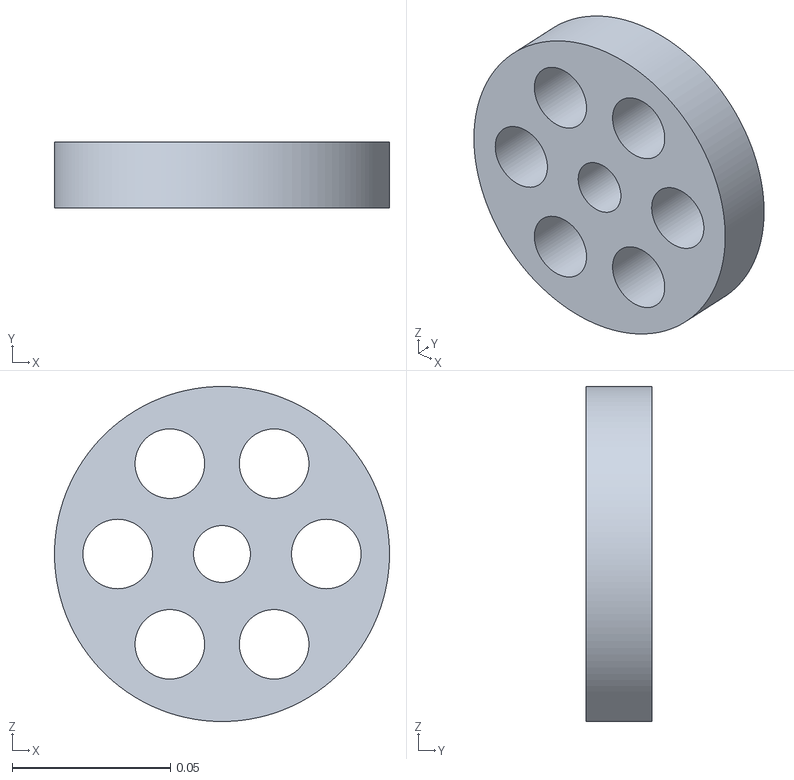
[picture p60: CAD file, 2026-11-04]
ros/oh_my_mobilerobot_description/meshes/visual/right_wheel_link/hub.stl
0.106 x 0.021 x 0.106
