Leehyunbin0131/Oh-My-MobileRobot/hardware/application-examples/cargo-concept.step

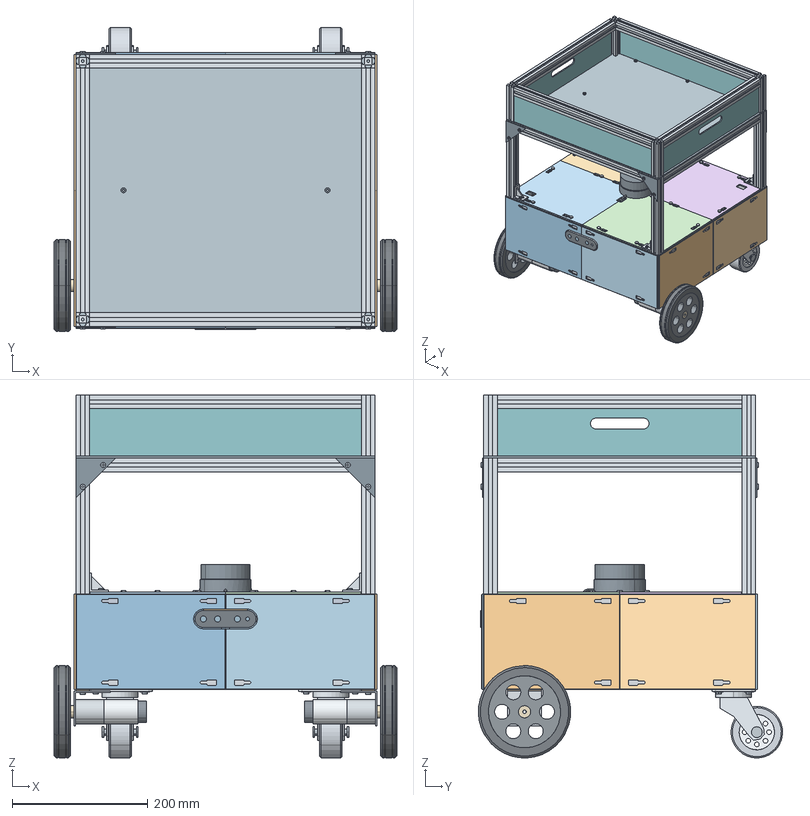
[picture p61: CAD file, 2026-11-04]
hardware/application-examples/cargo-concept.step
504.0 x 447.6 x 534.0 mm
