Leehyunbin0131/Oh-My-MobileRobot/hardware/electronics-tray/print/m3-pilot-fit-coupon.stl

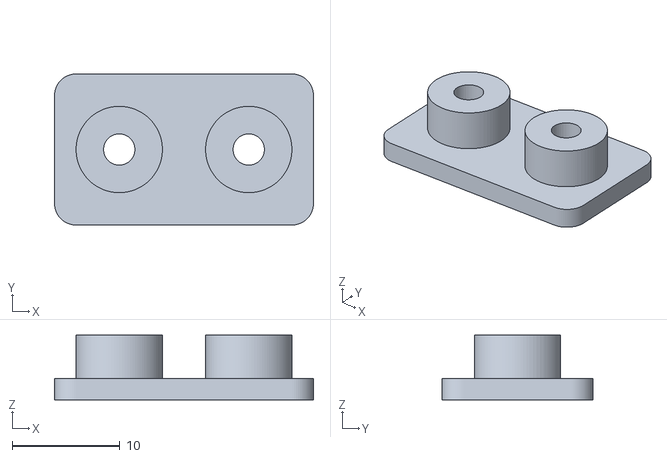
[picture p62: CAD file, 2026-11-04]
hardware/electronics-tray/print/m3-pilot-fit-coupon.stl
24.0 x 14.0 x 6.00
