Leehyunbin0131/Oh-My-MobileRobot/hardware/side-panels/cad/side-panel-200.step

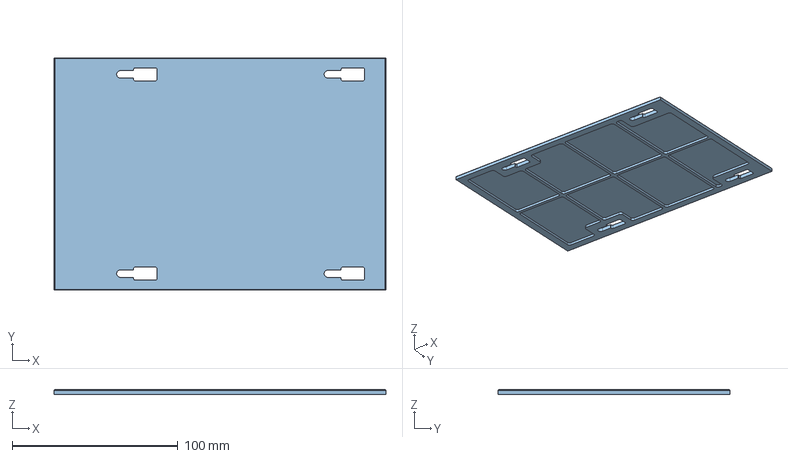
[picture p63: CAD file, 2026-11-04]
hardware/side-panels/cad/side-panel-200.step
200.0 x 140.0 x 3.00 mm
