Leehyunbin0131/Oh-My-MobileRobot/hardware/top-deck/print/01_Front_Left.stl

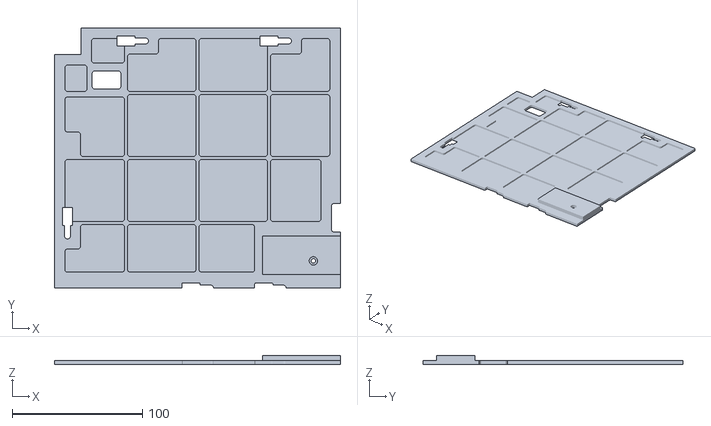
[picture p64: CAD file, 2026-11-04]
hardware/top-deck/print/01_Front_Left.stl
220.0 x 200.0 x 7.00
