Leehyunbin0131/Oh-My-MobileRobot/ros/oh_my_mobilerobot_description/meshes/visual/arm_module/fastener.stl

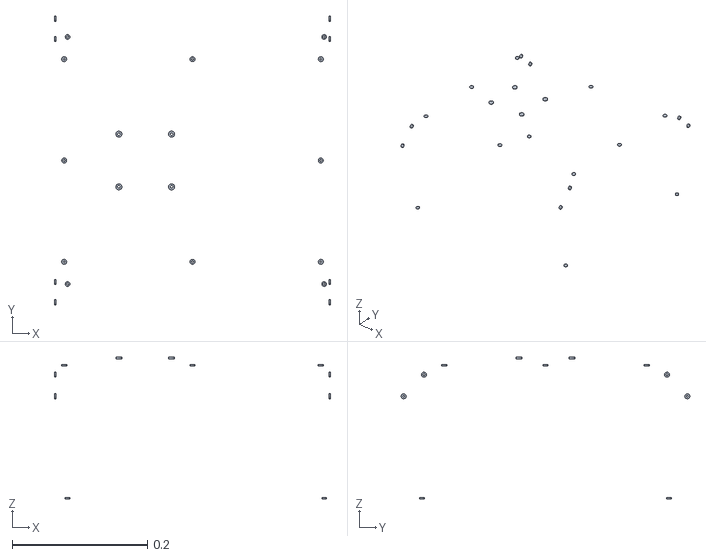
[picture p65: CAD file, 2026-11-04]
ros/oh_my_mobilerobot_description/meshes/visual/arm_module/fastener.stl
0.409 x 0.428 x 0.21
