Leehyunbin0131/Oh-My-MobileRobot/ros/oh_my_mobilerobot_description/meshes/visual/base_link/metal.stl

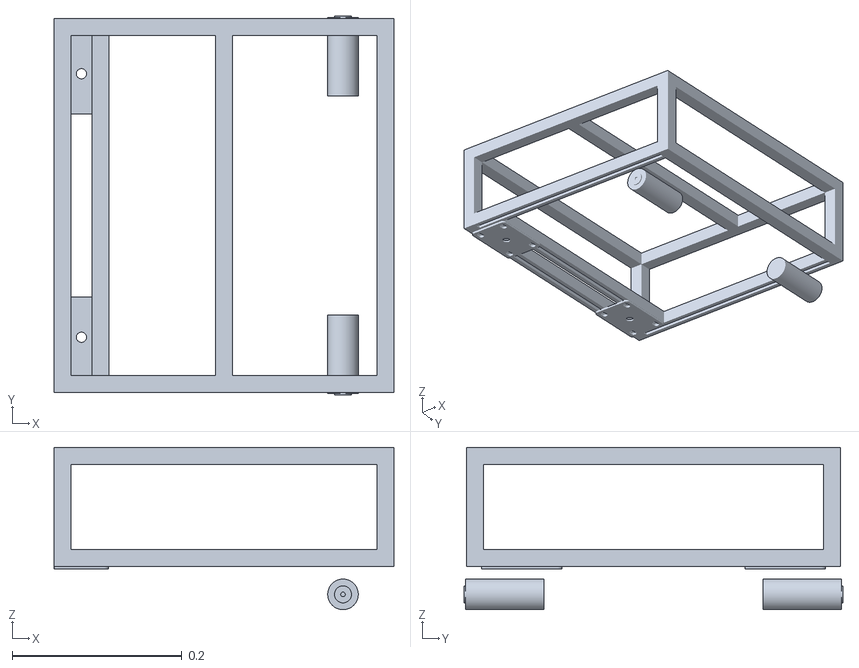
[picture p66: CAD file, 2026-11-04]
ros/oh_my_mobilerobot_description/meshes/visual/base_link/metal.stl
0.4 x 0.446 x 0.191
