Leehyunbin0131/Oh-My-MobileRobot/ros/oh_my_mobilerobot_description/meshes/visual/camera_link/optic.stl

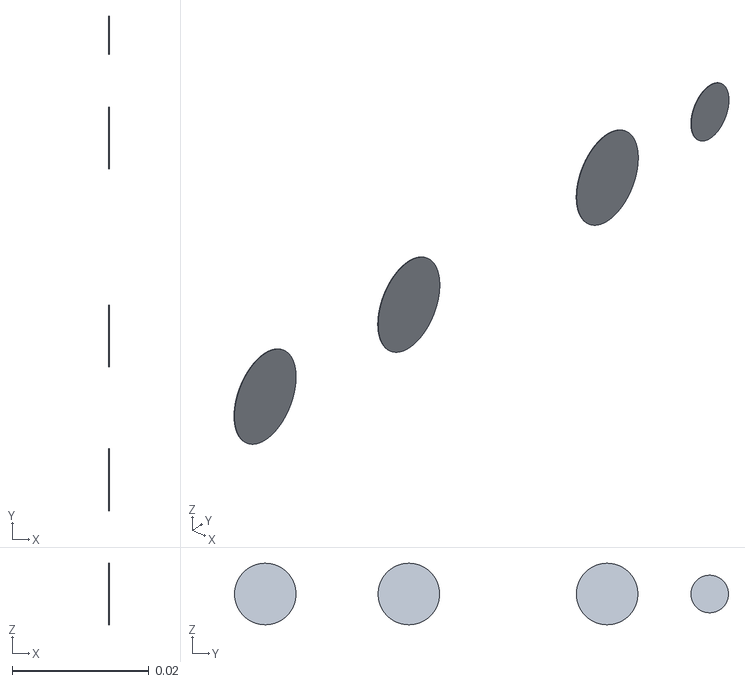
[picture p67: CAD file, 2026-11-04]
ros/oh_my_mobilerobot_description/meshes/visual/camera_link/optic.stl
6e-05 x 0.0722 x 0.009
