Leehyunbin0131/Oh-My-MobileRobot/ros/oh_my_mobilerobot_description/meshes/visual/display_module/display.stl

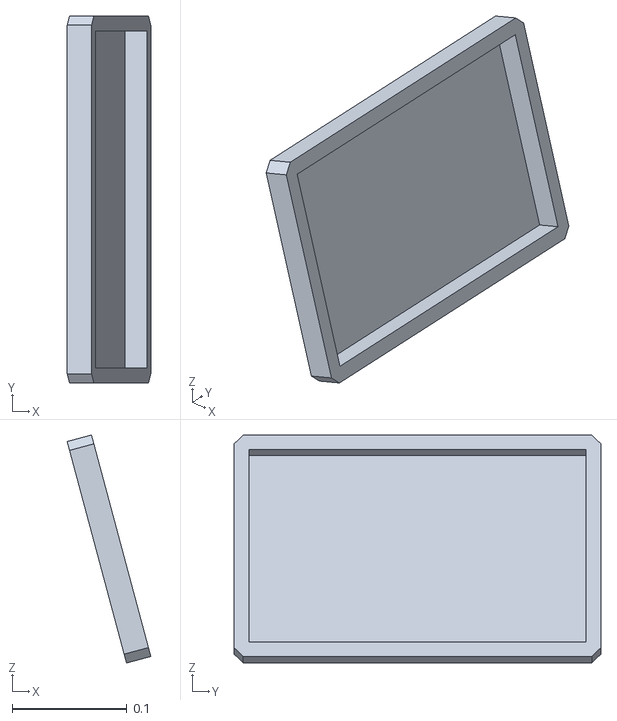
[picture p69: CAD file, 2026-11-04]
ros/oh_my_mobilerobot_description/meshes/visual/display_module/display.stl
0.073 x 0.32 x 0.199
