Leehyunbin0131/Oh-My-MobileRobot/ros/oh_my_mobilerobot_description/meshes/visual/lidar_link/optic.stl

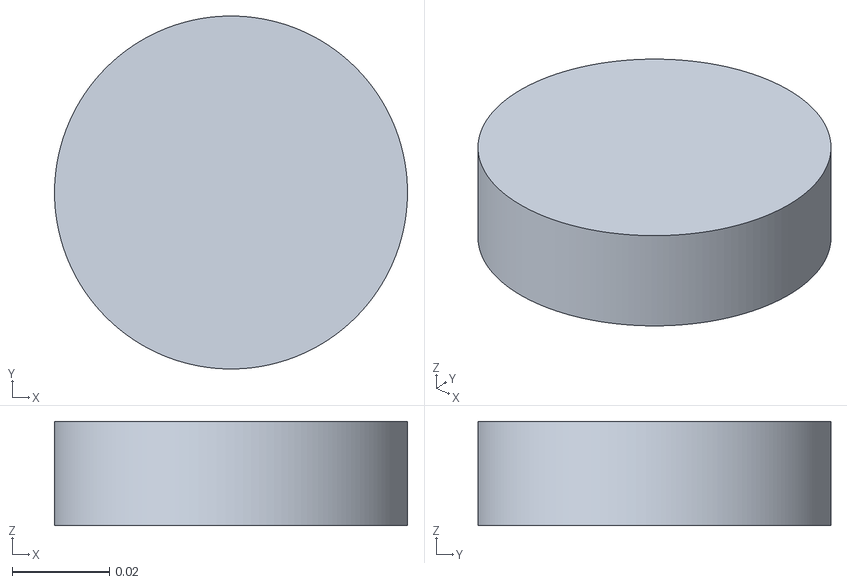
[picture p70: CAD file, 2026-11-04]
ros/oh_my_mobilerobot_description/meshes/visual/lidar_link/optic.stl
0.0725 x 0.0725 x 0.0214
