Leehyunbin0131/Oh-My-MobileRobot/ros/oh_my_mobilerobot_description/meshes/visual/base_link/bracket.stl

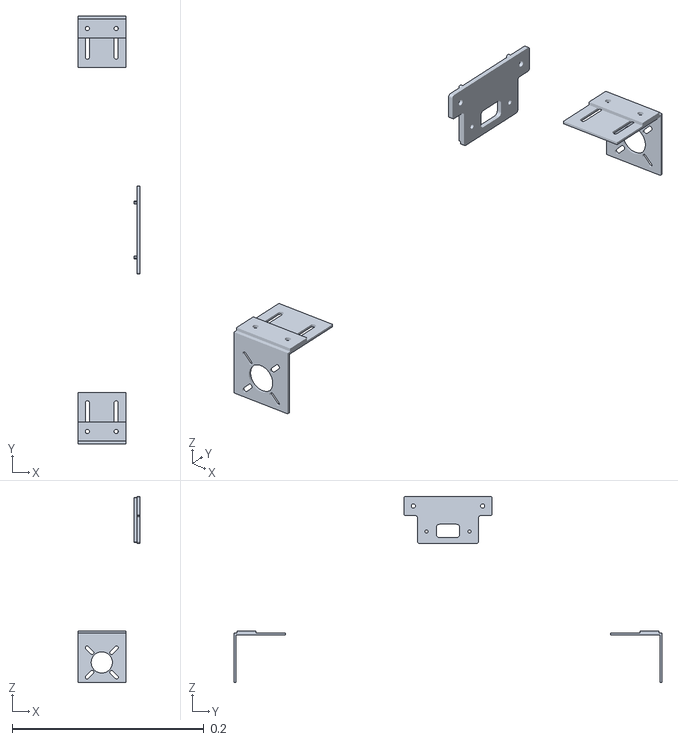
[picture p72: CAD file, 2026-11-04]
ros/oh_my_mobilerobot_description/meshes/visual/base_link/bracket.stl
0.065 x 0.446 x 0.194
