Leehyunbin0131/Oh-My-MobileRobot/ros/oh_my_mobilerobot_description/meshes/visual/base_link/fastener.stl

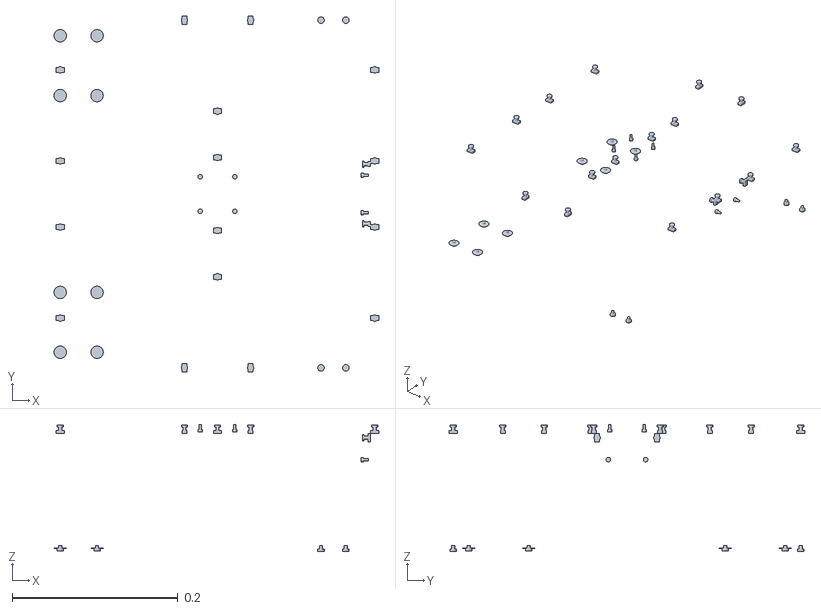
[picture p74: CAD file, 2026-11-04]
ros/oh_my_mobilerobot_description/meshes/visual/base_link/fastener.stl
0.393 x 0.43 x 0.153
