Leehyunbin0131/Oh-My-MobileRobot/ros/oh_my_mobilerobot_description/meshes/visual/base_link/cover.stl

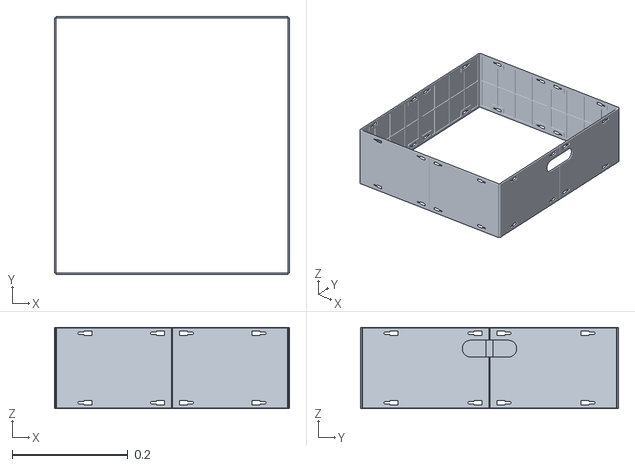
[picture p75: CAD file, 2026-11-04]
ros/oh_my_mobilerobot_description/meshes/visual/base_link/cover.stl
0.406 x 0.446 x 0.14
