Leehyunbin0131/Oh-My-MobileRobot/ros/oh_my_mobilerobot_description/meshes/visual/cargo_module/cover.stl

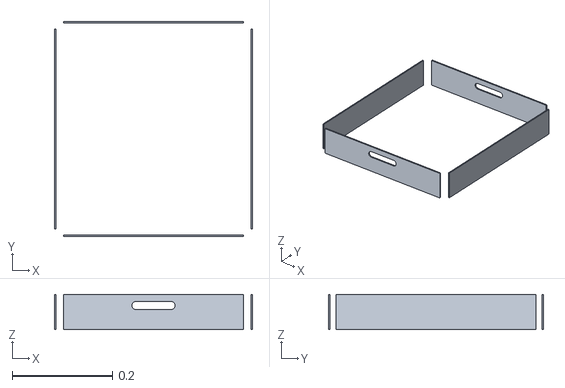
[picture p76: CAD file, 2026-11-04]
ros/oh_my_mobilerobot_description/meshes/visual/cargo_module/cover.stl
0.396 x 0.43 x 0.07
