Leehyunbin0131/Oh-My-MobileRobot/ros/oh_my_mobilerobot_description/meshes/visual/display_module/screen_text.stl

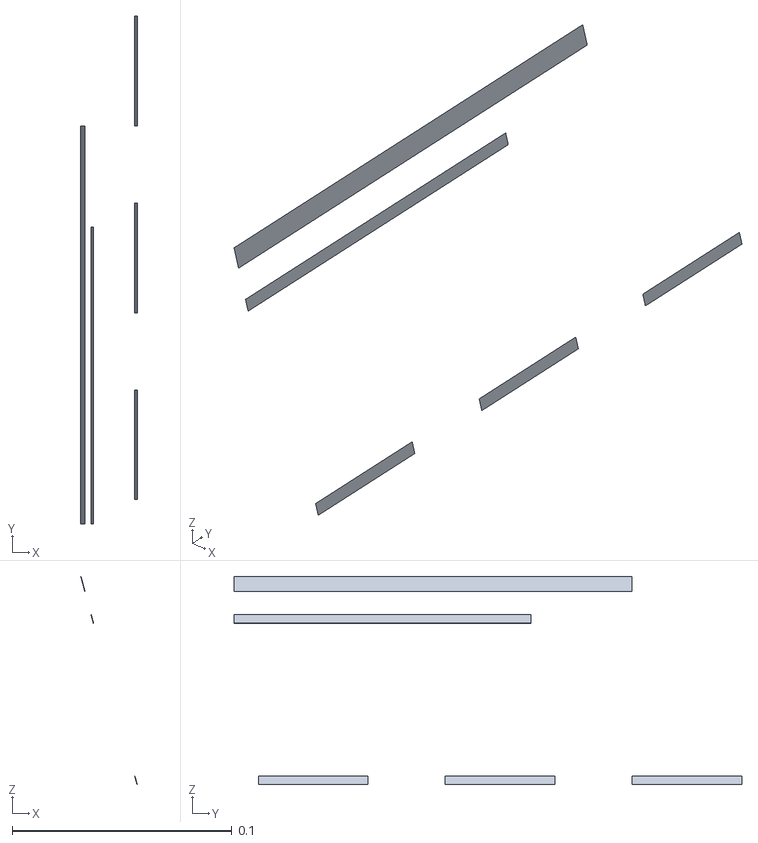
[picture p77: CAD file, 2026-11-04]
ros/oh_my_mobilerobot_description/meshes/visual/display_module/screen_text.stl
0.0258 x 0.231 x 0.0947
