Leehyunbin0131/Oh-My-MobileRobot/ros/oh_my_mobilerobot_description/meshes/visual/arm_module/accent.stl

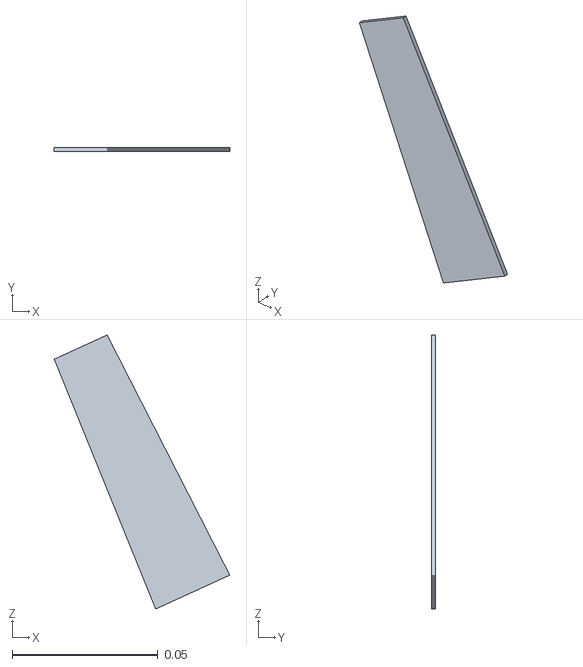
[picture p78: CAD file, 2026-11-04]
ros/oh_my_mobilerobot_description/meshes/visual/arm_module/accent.stl
0.0603 x 0.0015 x 0.0941
