Leehyunbin0131/Oh-My-MobileRobot/ros/oh_my_mobilerobot_description/meshes/visual/display_module/screen_card.stl

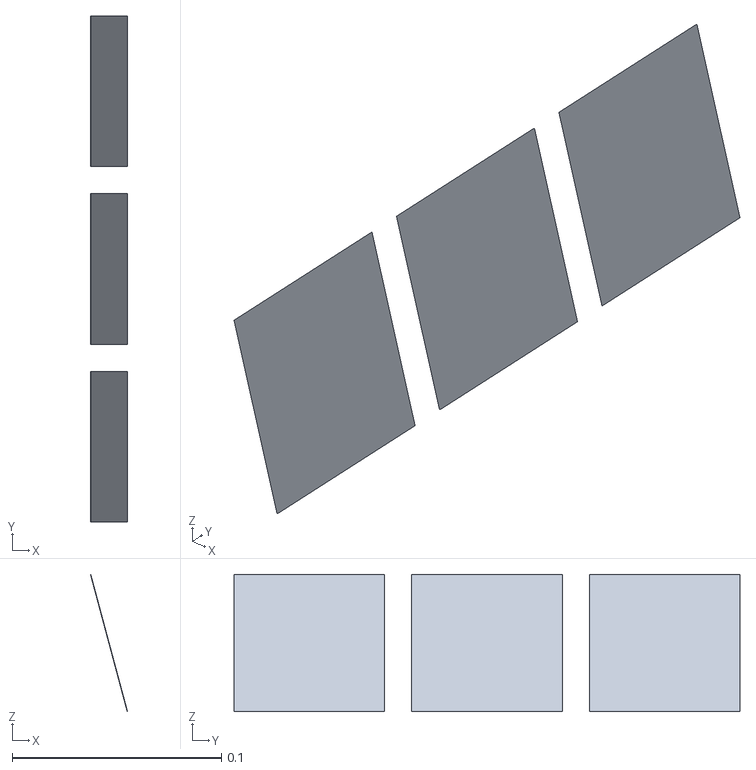
[picture p79: CAD file, 2026-11-04]
ros/oh_my_mobilerobot_description/meshes/visual/display_module/screen_card.stl
0.0178 x 0.242 x 0.0657
