Leehyunbin0131/Oh-My-MobileRobot/ros/oh_my_mobilerobot_description/meshes/visual/display_module/screen.stl

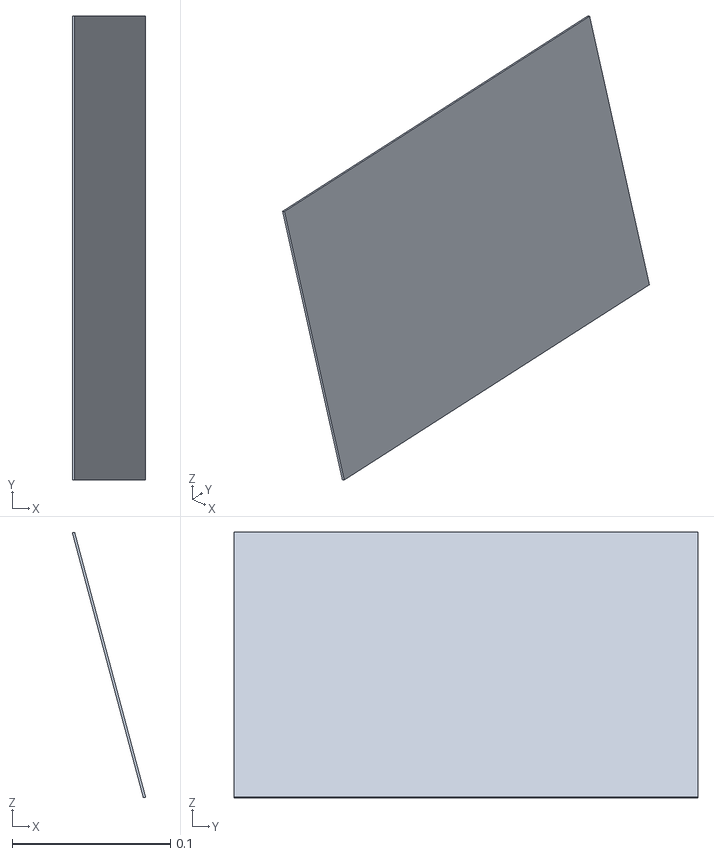
[picture p80: CAD file, 2026-11-04]
ros/oh_my_mobilerobot_description/meshes/visual/display_module/screen.stl
0.0464 x 0.294 x 0.168
