Leehyunbin0131/Oh-My-MobileRobot/(list of files, cad)

Other CAD files:
ros/oh_my_mobilerobot_description/meshes/visual/right_caster_swivel_link/metal.stl
ros/oh_my_mobilerobot_description/meshes/visual/right_caster_wheel_link/hub.stl
hardware/electronics-tray/print/upper-plate-converters.stl
hardware/top-deck/print/04_Rear_Right.stl
ros/oh_my_mobilerobot_description/meshes/visual/left_wheel_link/rubber.stl
ros/oh_my_mobilerobot_description/meshes/visual/right_caster_swivel_link/fastener.stl
hardware/camera-mount/cad/camera-panel-left.step
ros/oh_my_mobilerobot_description/meshes/visual/left_wheel_link/hub.stl
ros/oh_my_mobilerobot_description/meshes/visual/right_wheel_link/metal.stl
hardware/top-deck/print/02_Front_Right.stl
hardware/camera-mount/print/camera-panel-left.stl
hardware/camera-mount/print/camera-panel-right.stl
hardware/camera-mount/print/d435i-bracket-v2.stl
hardware/side-panels/print/side-panel-180.stl
hardware/side-panels/print/side-panel-200.stl
hardware/side-panels/print/side-panel-220.stl
