Leehyunbin0131/Oh-My-MobileRobot/hardware/top-deck/drawings/top-deck-1to1.pdf

# 로봇 상판 - M4 키홀 16개 / A2M12 / XT60

## 440 × 400 / 각 판 220 × 200 / 표면 1 + 아래 리브 2 / 중앙만 아래쪽으로 국부 보강

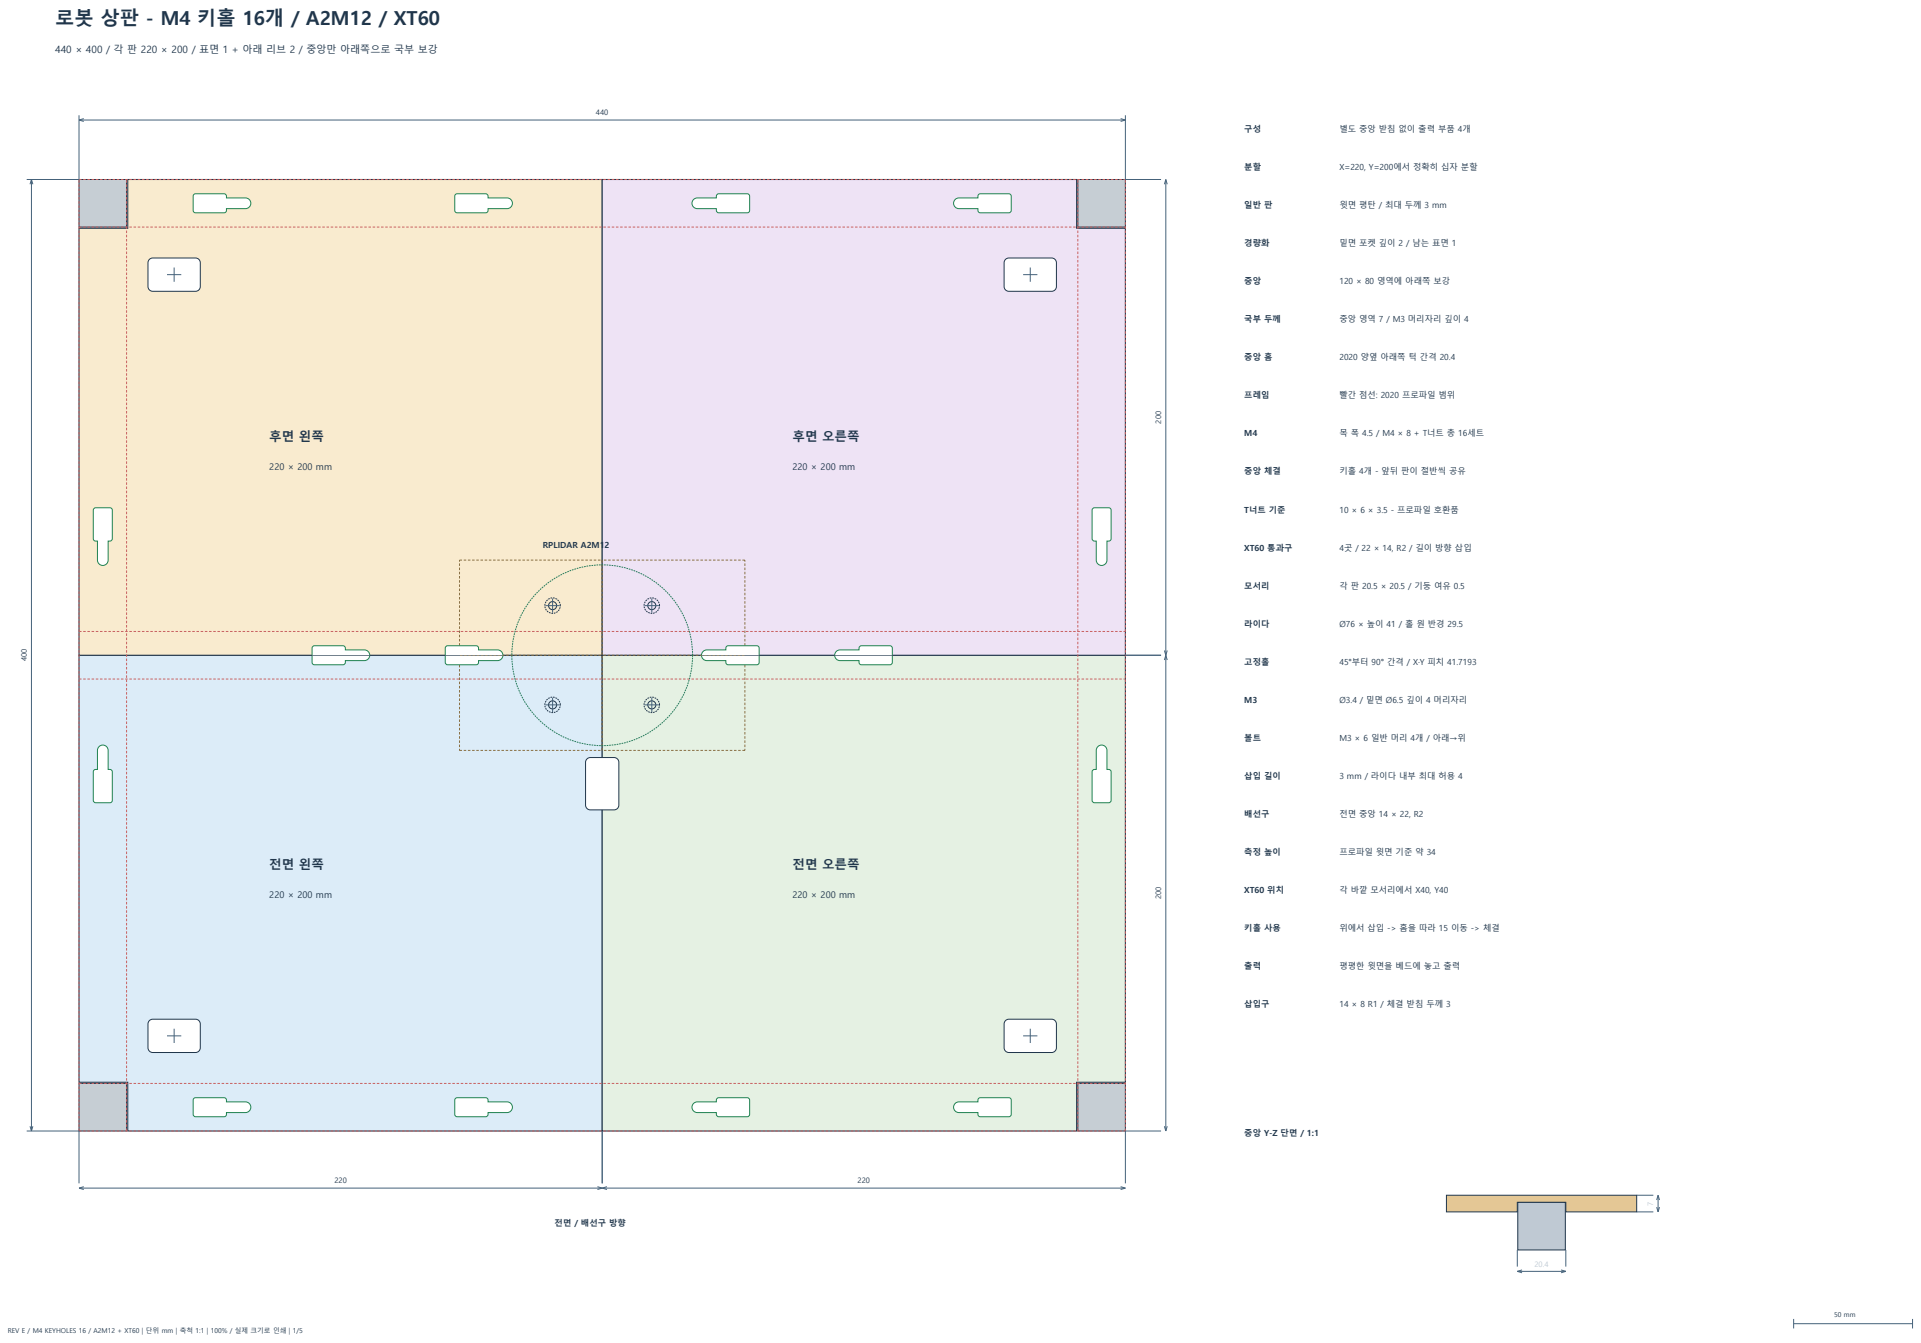
[picture p81: page 1]
전면 오른쪽; 후면 오른쪽; RPLIDAR A2M12; X=220, Y=200에서 정확히 십자 분할; 경량화; 120 × 80 영역에 아래쪽 보강; 중앙 영역 7 / M3 머리자리 깊이 4; 2020 양옆 아래쪽 턱 간격 20.4; 프레임; 빨간 점선: 2020 프로파일 범위; 목 폭 4.5 / M4 × 8 + T너트 총 16세트; 키홀 4개 - 앞뒤 판이 절반씩 공유; T너트 기준; 10 × 6 × 3.5 - 프로파일 호환품; XT60 통과구; 모서리; 라이다; 고정홀; Ø3.4 / 밑면 Ø6.5 깊이 4 머리자리; 3 mm / 라이다 내부 최대 허용 4; 배선구; 프로파일 윗면 기준 약 34; 각 바깥 모서리에서 X40, Y40; 위에서 삽입 -> 홈을 따라 15 이동 -> 체결; 평평한 윗면을 베드에 놓고 출력; 삽입구

전면 / 배선구 방향

REV E / M4 KEYHOLES 16 / A2M12 + XT60 | 단위 mm | 축척 1:1 | 100% / 실제 크기로 인쇄 | 1/5

# 01 전면 왼쪽 - 220 × 200

## 가공 / 출력 형상

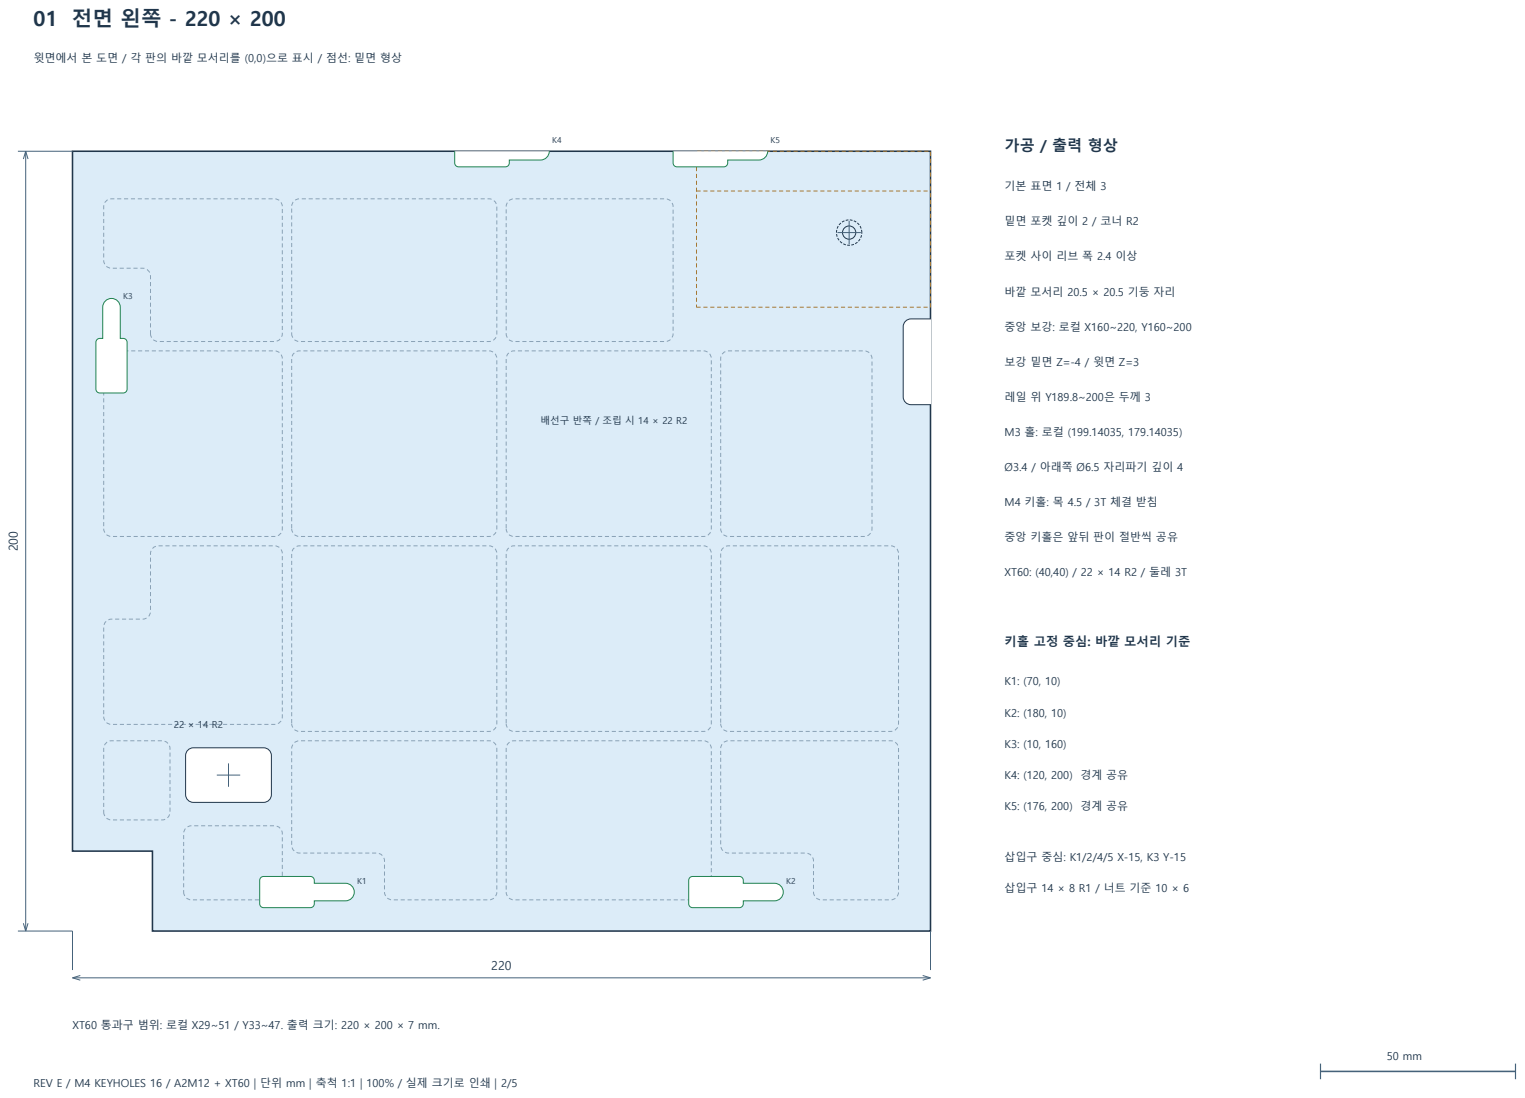
[picture p82: page 2]
삽입구 중심: K1/2/4/5 X-15, K3 Y-15

윗면에서 본 도면 / 각 판의 바깥 모서리를 (0,0)으로 표시 / 점선: 밑면 형상

바깥 모서리 20.5 × 20.5 기둥 자리

배선구 반쪽 / 조립 시 14 × 22 R2

Ø3.4 / 아래쪽 Ø6.5 자리파기 깊이 4

중앙 키홀은 앞뒤 판이 절반씩 공유

키홀 고정 중심: 바깥 모서리 기준

삽입구 14 × 8 R1 / 너트 기준 10 × 6

XT60 통과구 범위: 로컬 X29~51 / Y33~47. 출력 크기: 220 × 200 × 7 mm.

REV E / M4 KEYHOLES 16 / A2M12 + XT60 | 단위 mm | 축척 1:1 | 100% / 실제 크기로 인쇄 | 2/5

# 02 전면 오른쪽 - 220 × 200

## 가공 / 출력 형상

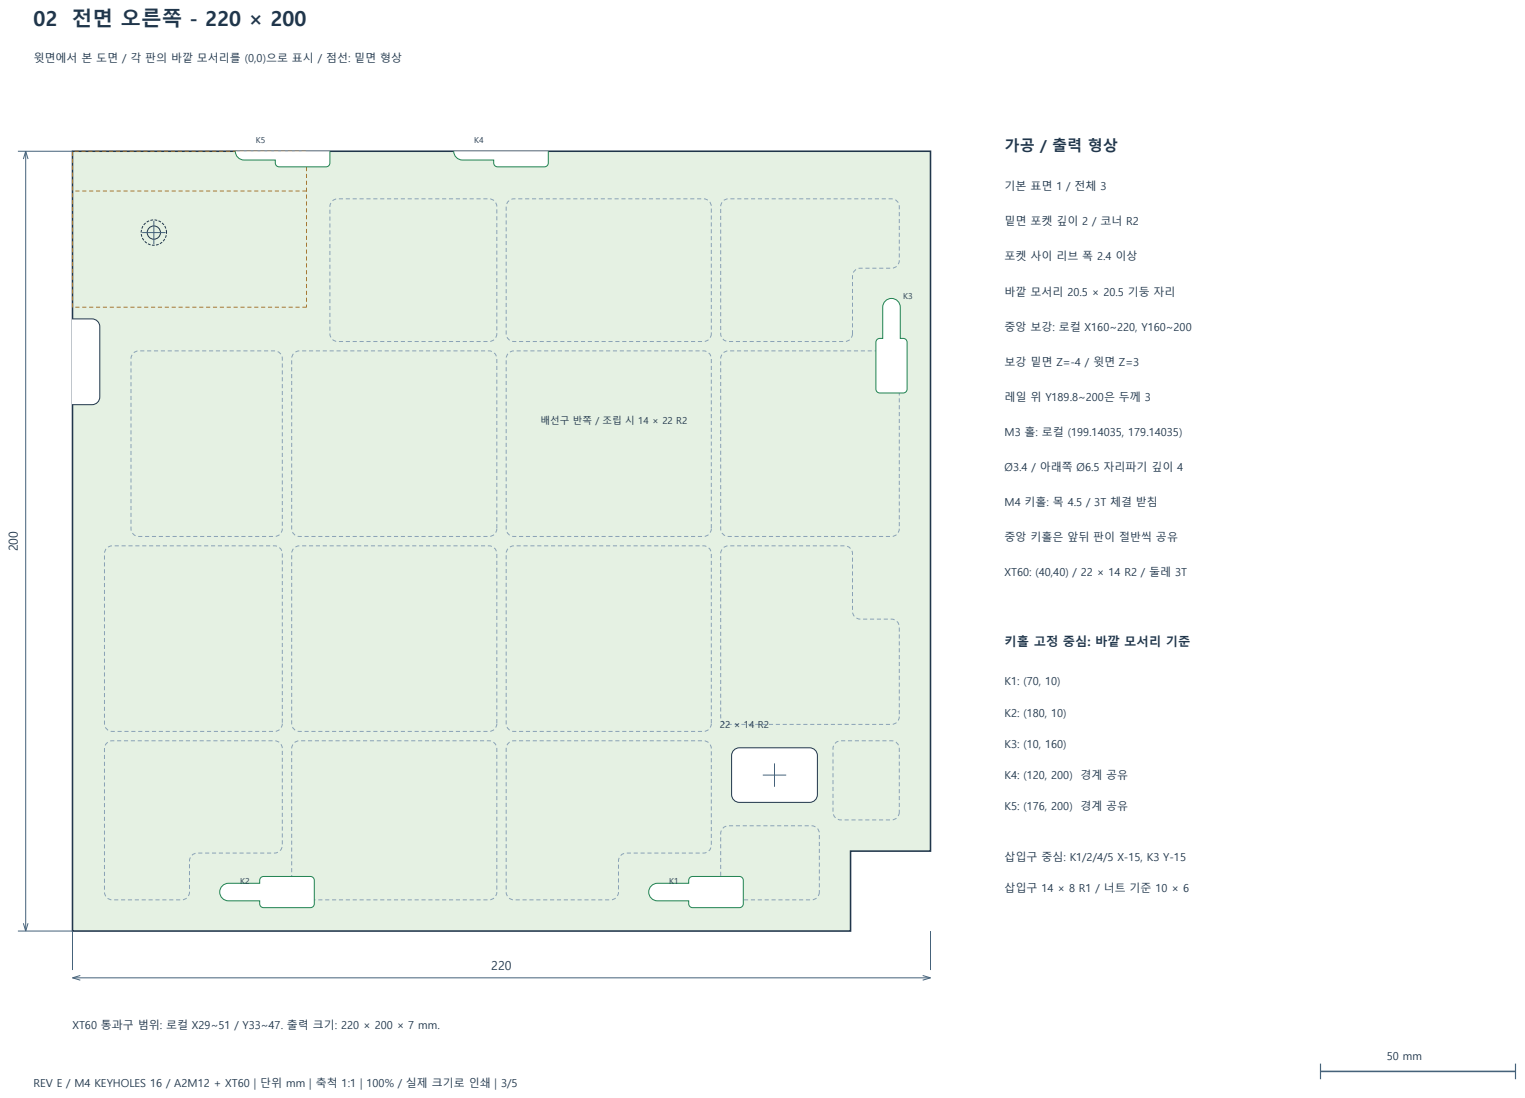
[picture p83: page 3]
삽입구 중심: K1/2/4/5 X-15, K3 Y-15

바깥 모서리 20.5 × 20.5 기둥 자리

배선구 반쪽 / 조립 시 14 × 22 R2

Ø3.4 / 아래쪽 Ø6.5 자리파기 깊이 4

중앙 키홀은 앞뒤 판이 절반씩 공유

키홀 고정 중심: 바깥 모서리 기준

삽입구 14 × 8 R1 / 너트 기준 10 × 6

XT60 통과구 범위: 로컬 X29~51 / Y33~47. 출력 크기: 220 × 200 × 7 mm.

REV E / M4 KEYHOLES 16 / A2M12 + XT60 | 단위 mm | 축척 1:1 | 100% / 실제 크기로 인쇄 | 3/5

# 03 후면 왼쪽 - 220 × 200

## 가공 / 출력 형상

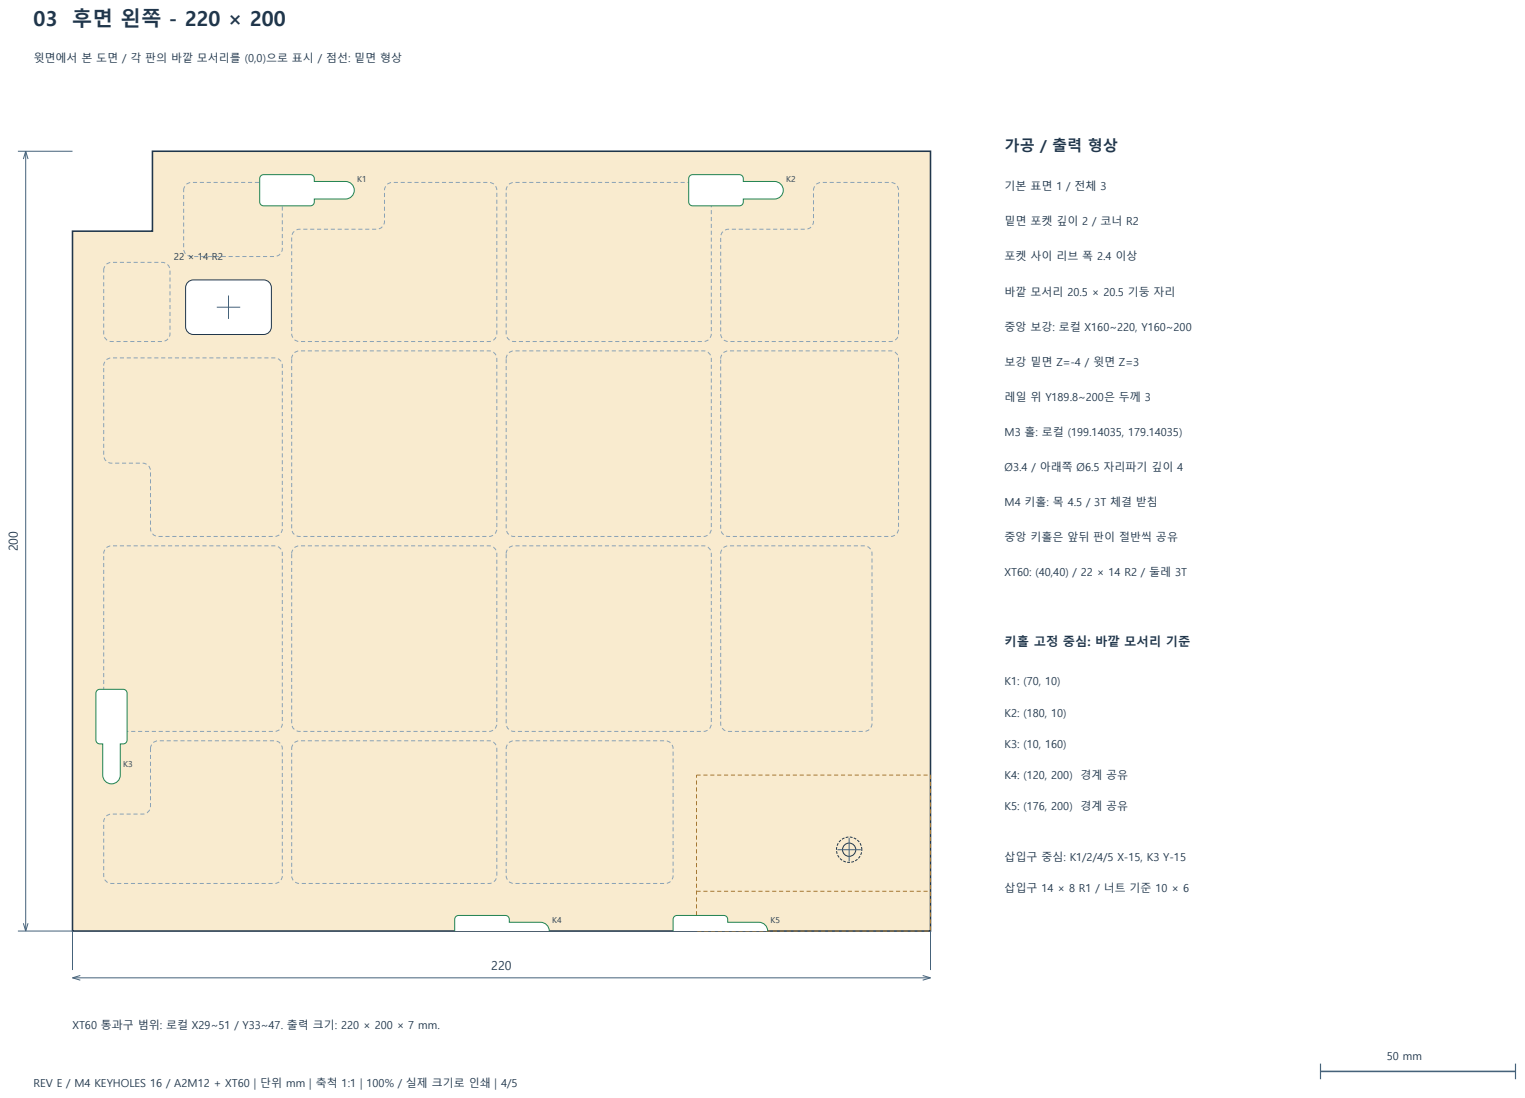
[picture p84: page 4]
삽입구 중심: K1/2/4/5 X-15, K3 Y-15

바깥 모서리 20.5 × 20.5 기둥 자리

Ø3.4 / 아래쪽 Ø6.5 자리파기 깊이 4

중앙 키홀은 앞뒤 판이 절반씩 공유

키홀 고정 중심: 바깥 모서리 기준

삽입구 14 × 8 R1 / 너트 기준 10 × 6

XT60 통과구 범위: 로컬 X29~51 / Y33~47. 출력 크기: 220 × 200 × 7 mm.

REV E / M4 KEYHOLES 16 / A2M12 + XT60 | 단위 mm | 축척 1:1 | 100% / 실제 크기로 인쇄 | 4/5

# 04 후면 오른쪽 - 220 × 200

## 가공 / 출력 형상

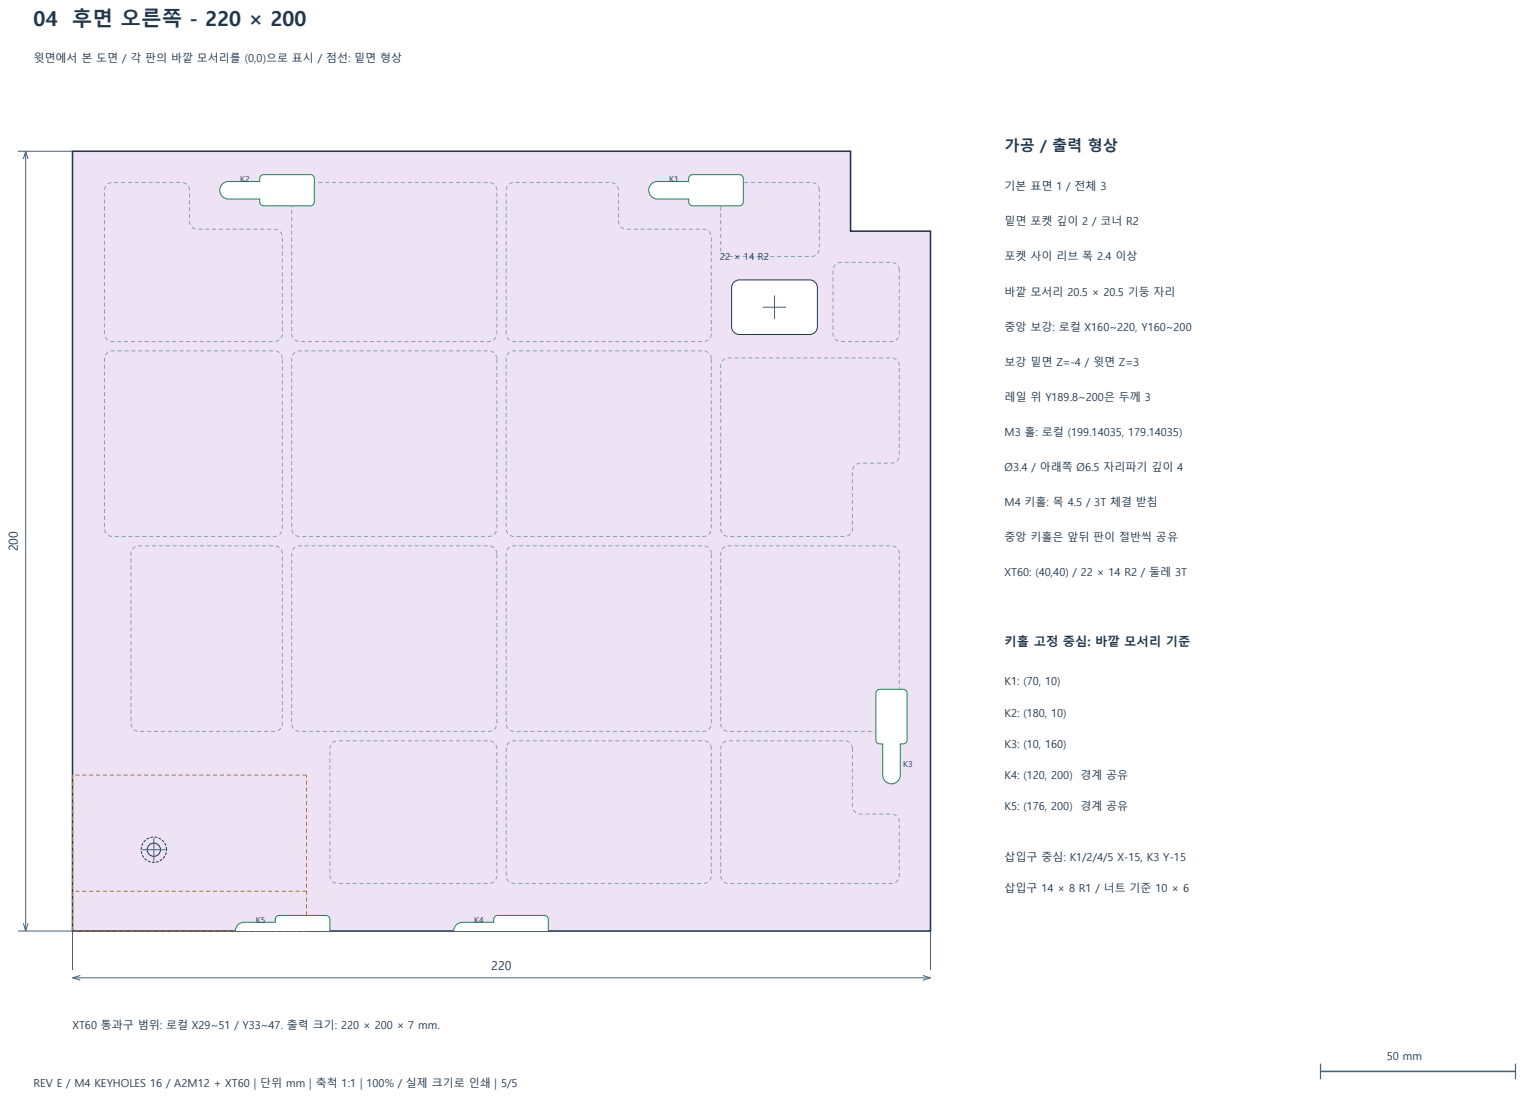
[picture p85: page 5]
삽입구 중심: K1/2/4/5 X-15, K3 Y-15

바깥 모서리 20.5 × 20.5 기둥 자리

Ø3.4 / 아래쪽 Ø6.5 자리파기 깊이 4

중앙 키홀은 앞뒤 판이 절반씩 공유

키홀 고정 중심: 바깥 모서리 기준

삽입구 14 × 8 R1 / 너트 기준 10 × 6

XT60 통과구 범위: 로컬 X29~51 / Y33~47. 출력 크기: 220 × 200 × 7 mm.

REV E / M4 KEYHOLES 16 / A2M12 + XT60 | 단위 mm | 축척 1:1 | 100% / 실제 크기로 인쇄 | 5/5
