Leehyunbin0131/Oh-My-MobileRobot/(commit log)

2026-11-04 feat: add mobile robot hardware designs and documentation
    Include parametric CAD, printable parts, exterior assemblies, application concepts, drawings, and bilingual hardware documentation under CERN-OHL-P-2.0.
    [01_Front_Left.stl, 02_Front_Right.stl, 03_Rear_Left.stl, 04_Rear_Right.stl, arm-concept.step, camera-panel-left.step, camera-panel-left.stl, camera-panel-right.step]
2026-11-04 feat: add ROS 1 and ROS 2 model support
    Provide four CAD-derived URDF variants, shared Xacro and visual meshes, ROS launch files, regeneration tools, and model usage documentation.
    [accent.stl, arm.stl, arm.urdf, base.urdf, bracket.stl, cargo.urdf, cover.stl, deck.stl]
2026-11-04 docs: add README banner and model gallery
    Present the CAD lineup, centered project introduction and document links, plus the large base and application images in both languages.
2026-11-04 fix: add top-deck T-nut keyholes and reduce frame fasteners
    [01_Front_Left.stl, 02_Front_Right.stl, 03_Rear_Left.stl, 04_Rear_Right.stl, arm-concept.step, arm.stl, bracket.stl, cargo-concept.step]
2026-11-06 docs: add frame/fastener BOM tables, part preview images, and unify nav bars
